camerondm9/ece4600capstone/README.md

# ece4600capstone
This repository is for storing files related to our Capstone project.
