camerondm9/ece4600capstone/Mechanical/Renders/Emittor 1.png

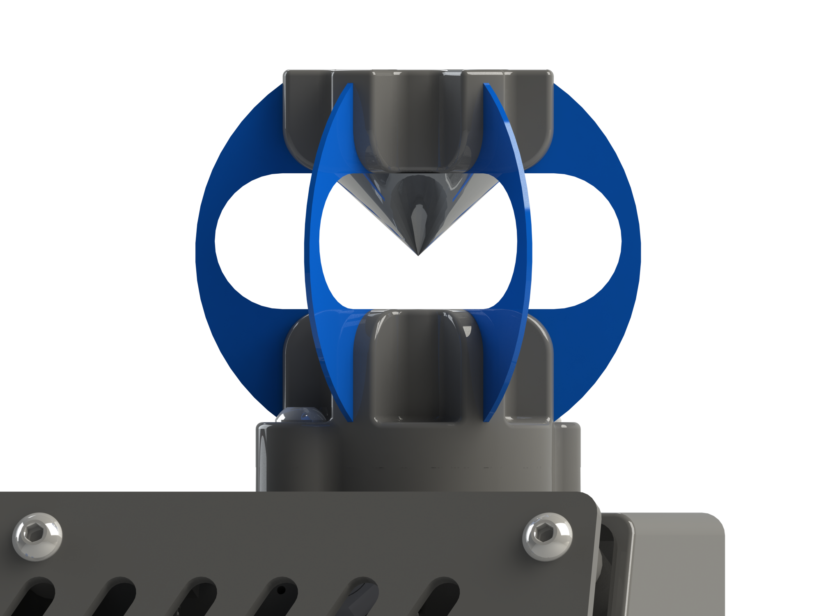
Mechanical/Renders/Emittor 1.png
