camerondm9/ece4600capstone/Mechanical/Renders/Isometric 2.png

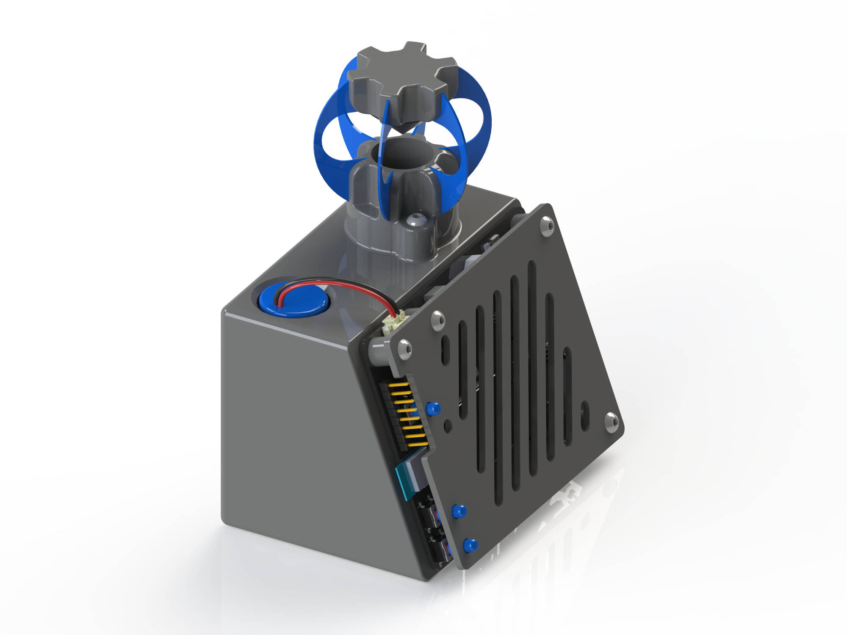
Mechanical/Renders/Isometric 2.png
