camerondm9/ece4600capstone/Mechanical/Renders/Isometric.png

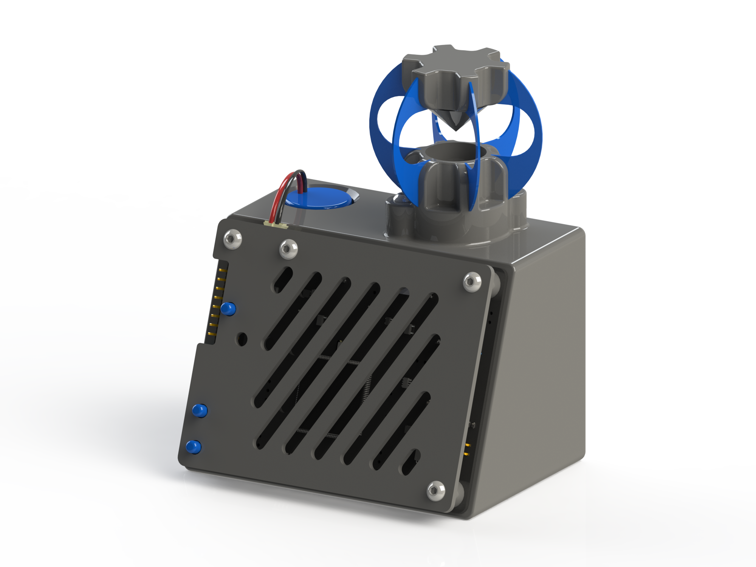
Mechanical/Renders/Isometric.png
