camerondm9/ece4600capstone/PCB/bom/layout.csv

Id | Designator | Package | Quantity | Designation | Supplier and ref
1 | D3,D2 | DO-220AA | 2 | 560mV 2.1A
2 | R28,R3 | R_0603_HandSoldering | 2 | 20k
3 | R27 | R_0603_HandSoldering | 1 | 100m
4 | R26,R21,R48,R46,R14 | R_0603_HandSoldering | 5 | 220k
5 | R25 | R_0603_HandSoldering | 1 | 100
6 | R24,R20,R19,R60,R59,R58,R57,R45,R39,R38,R37,R36,R35,R33,R32,R31,R30,R29,R17,R7 | R_0603_HandSoldering | 20 | 10k
7 | R23 | R_0603_HandSoldering | 1 | 392k
8 | R22,R64,R62,R9 | R_0603_HandSoldering | 4 | 30k
9 | R18 | R_0603_HandSoldering | 1 | 86.6k
10 | C89 | C_1206_HandSoldering | 1 | 2.2uF
11 | U18,U19 | TDFN8-PAD | 2 | MAX5394L
12 | Ref** | BottomLogo | 1 | Val**
13 | C99,C98,C97,C96 | C_0805_HandSoldering | 4 | 68nF
14 | C103,C101,C94,C84,C81,C71,C70,C29,C28,C22,C21,C19,C18,C14,C13,C12,C11,C10,C8,C3,C2,C1 | C_0805_HandSoldering | 22 | 10uF
15 | R61,R44,R34 | R_0603_HandSoldering | 3 | 1k
16 | L6 | SRU1048-151Y | 1 | 150uH
17 | U12 | EQFP144-PAD | 1 | 10CL010
18 | L5 | NRS6045T100MMGK | 1 | 10uH
19 | C15,C16,C4 | CP_Radial_D6.3mm_P2.50mm | 3 | 330uF
20 | NT2,NT4,NT3,NT1 | NetTie-2 | 4 | Net-Tie_2
21 | SW1,SW2,SW3 | PTS645SK43SM | 3 | SW_Push
22 | H4,H3,H2,H1 | MountingHole_4mm_Pad_Via | 4 | MountingHole_Pad
23 | J1 | JST_S2B-PH-SM4-TB | 1 | S2B-PH-SM4-TB
24 | U1 | WSON10-PAD | 1 | TPS63031
25 | J8 | Pin_Header_Straight_1x08_Pitch2.54mm | 1 | DNP
26 | J5 | Pin_Header_Straight_1x15_Pitch2.54mm | 1 | DNP
27 | U7 | SOIC8 | 1 | W25Q80DV
28 | J12 | Pin_Header_Straight_1x04_Pitch2.54mm | 1 | DNP
29 | U13 | ECS-5032MV | 1 | ECS-5032MV
30 | C49,C102,C100,C93,C92,C91,C85,C83,C79,C78,C68,C67,C66,C48,C47,C46,C45,C44,C37,C27,C26,C25,C24,C20,C5 | C_0603_HandSoldering | 25 | 100nF
31 | J10 | Pin_Header_Straight_2x05_Pitch2.54mm | 1 | DNP
32 | U21 | SSOP14 | 1 | TLV3544
33 | U22 | SOT23-5 | 1 | MCP6L1
34 | U20 | SOT23 | 1 | MAX11116
35 | U17 | SSOP8 | 1 | ADA4522-1
36 | U16 | TSOT8 | 1 | AD5450
37 | U15 | SOIC8-PAD | 1 | LTC6090-5
38 | U14 | SOT23-5 | 1 | TSX9291
39 | U11 | SSOP8 | 1 | LM3478
40 | U10 | SOT23-5 | 1 | AP2204K-ADJ
41 | U9 | WSON6-3x3-PAD | 1 | LMR62421
42 | U8 | LGA12 | 1 | LIS2DE12
43 | U6 | QFN4-PAD | 1 | ENS210
44 | U5 | SOT353 | 1 | MIC841N
45 | U4 | BMD-360 | 1 | BMD-360
46 | U3 | WSON6-2x2-PAD | 1 | TPS62262
47 | U2 | SOT23-5 | 1 | TCR2EF25
48 | R65 | R_1206_HandSoldering | 1 | 10k
49 | R63 | R_0603_HandSoldering | 1 | 1
50 | R56,R55 | R_0603_HandSoldering | 2 | 330
51 | R54,R53 | R_0603_HandSoldering | 2 | 2.7k
52 | R52,R51 | R_0603_HandSoldering | 2 | 7.5k
53 | R50,R49 | R_0603_HandSoldering | 2 | 47k
54 | R47 | R_0603_HandSoldering | 1 | 10
55 | R43,R42,R40 | R_0603_HandSoldering | 3 | 15k
56 | R41 | R_0603_HandSoldering | 1 | 75k
57 | R16 | R_0603_HandSoldering | 1 | 27k
58 | R15,R6,R4 | R_0603_HandSoldering | 3 | 3.3k
59 | R13,R12 | R_0603_HandSoldering | 2 | 470k
60 | R11,R5 | R_0603_HandSoldering | 2 | 30
61 | R10,R8 | R_0603_HandSoldering | 2 | 47
62 | R2,R1 | R_0805_HandSoldering | 2 | 100m
63 | Q1 | UDFN6-FET-PAD | 1 | SSM6K361NU
64 | L4,L2 | R_0805_HandSoldering | 2 | 100nH
65 | L3,L1 | Inductor_Taiyo-Yuden_MD-3030 | 2 | 2.2uH
66 | JP8,JP7,JP6,JP5,JP4,JP3,JP2,JP1 | SolderJumper_0603 | 8 | 0
67 | J11,J9,J7,J6,J3 | Pin_Header_Straight_1x02_Pitch2.54mm | 5 | DNP
68 | J4 | Pin_Header_Straight_1x08_Pitch2.54mm | 1 | PH1-08-UA
69 | J2 | Pin_Header_Straight_1x02_Pitch2.54mm | 1 | TRANSDUCER
70 | D8,D7,D5,D4 | D_SOD-523 | 4 | 600mV 200mA
71 | D6 | D_SOD-123 | 1 | 2.7V
72 | D1 | CLMVC-FKA | 1 | LED_ABGR
73 | C104,C90,C57,C56,C55,C54,C53,C52,C51,C50,C32 | C_0603_HandSoldering | 11 | 2.2nF
74 | C95,C87,C86 | C_1206_HandSoldering | 3 | 100nF
75 | C88,C82 | C_1206_HandSoldering | 2 | 220nF
76 | C80,C69,C17,C9,C7,C6 | C_0603_HandSoldering | 6 | 1uF
77 | C77,C76,C75,C74,C73,C72,C65,C64,C63,C62,C61,C60,C59,C58 | C_0603_HandSoldering | 14 | 22nF
78 | C43 | C_0603_HandSoldering | 1 | 10pF
79 | C42,C41,C40 | C_0603_HandSoldering | 3 | 220pF
80 | C39,C38 | CP_Radial_D10.0mm_P5.00mm | 2 | 220uF
81 | C36,C35,C31,C30 | C_1206_HandSoldering | 4 | 10uF
82 | C34,C33 | C_0805_HandSoldering | 2 | 1uF
83 | C23 | C_0603_HandSoldering | 1 | 10nF
