camerondm9/ece4600capstone/Datasheets/Parts.txt

Radio module:
	uBlox BMD-360
	https://www.digikey.ca/product-detail/en/u-blox-america-inc/BMD-360-A-R/1604-BMD-360-A-RCT-ND/10279460
	(has microcontroller)

Microcontroller:
	Nordic nRF52811
	(on radio module)

Transducer:
	Unictron A300A
	https://www.digikey.ca/product-detail/en/unictron-technologies-corporation/H2KA300KA1CD00/2047-H2KA300KA1CD00-ND/9921568

OpAmps:
	Maxim MAX412
	https://www.digikey.ca/product-detail/en/maxim-integrated/MAX412BCPA/MAX412BCPA-ND/1701712

	TI OPA604
	https://www.digikey.ca/product-detail/en/texas-instruments/OPA604AP/OPA604AP-ND/251162

FPGA:
	Intel/Altera 10CL010YE144C8G
	https://www.digikey.ca/product-detail/en/intel/10CL010YE144C8G/544-3578-ND/7593560
	https://www.intel.com/content/www/us/en/programmable/products/fpga/cyclone-series/cyclone-10/cyclone-10-lp/support.html
