camerondm9/ece4600capstone/Mechanical/Emittor Cover.SLDPRT

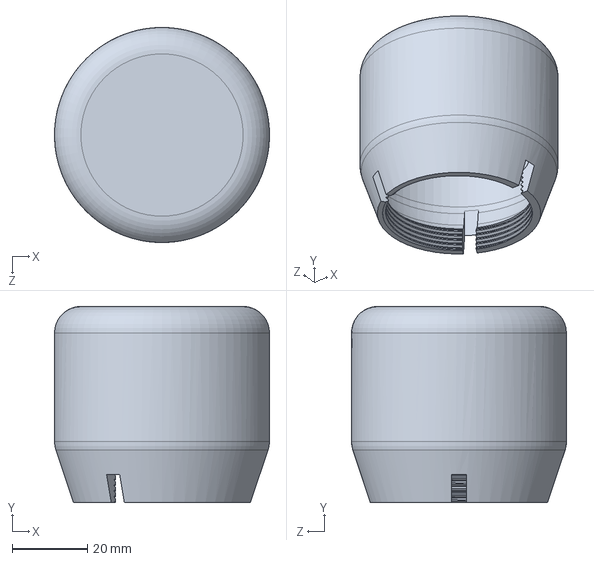
[picture p4: CAD file, 2020-02-05]
Mechanical/Emittor Cover.SLDPRT
57.0 x 52.0 x 57.0 mm
