camerondm9/ece4600capstone/PCB/Parts.3d/DO-220AA.step

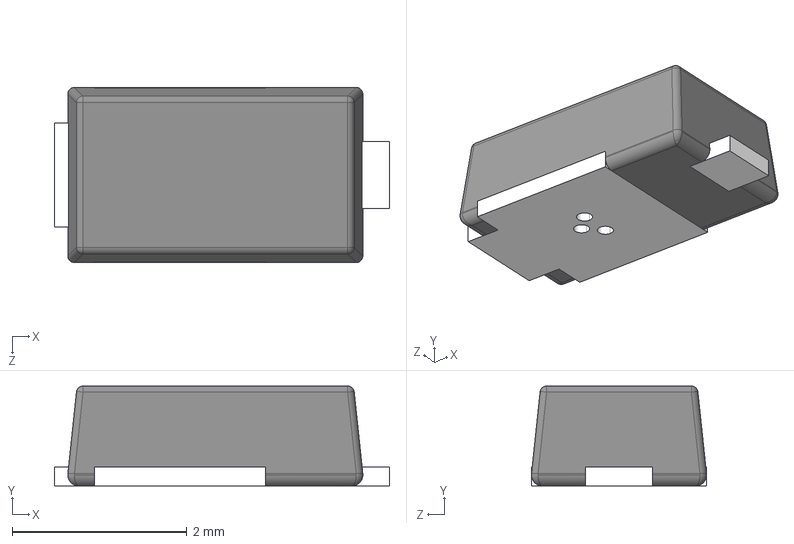
[picture p5: CAD file, 2020-01-10]
PCB/Parts.3d/DO-220AA.step
3.83 x 1.14 x 2.00 mm
