camerondm9/ece4600capstone/Mechanical/Cone Support.SLDPRT

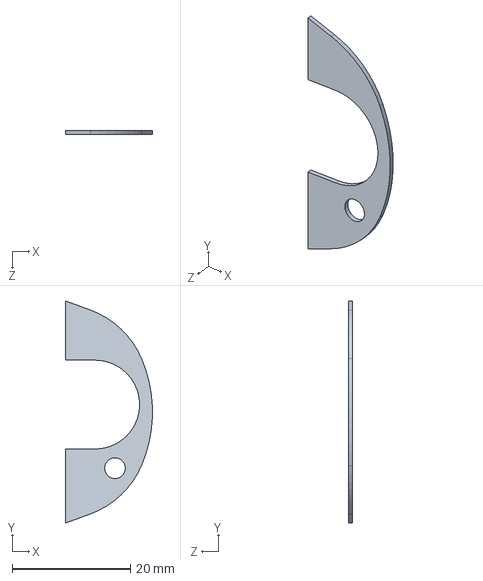
[picture p6: CAD file, 2020-02-05]
Mechanical/Cone Support.SLDPRT
14.7 x 37.5 x 0.7 mm
