camerondm9/ece4600capstone/PCB/Parts.3d/LQH3NP_M0.stp

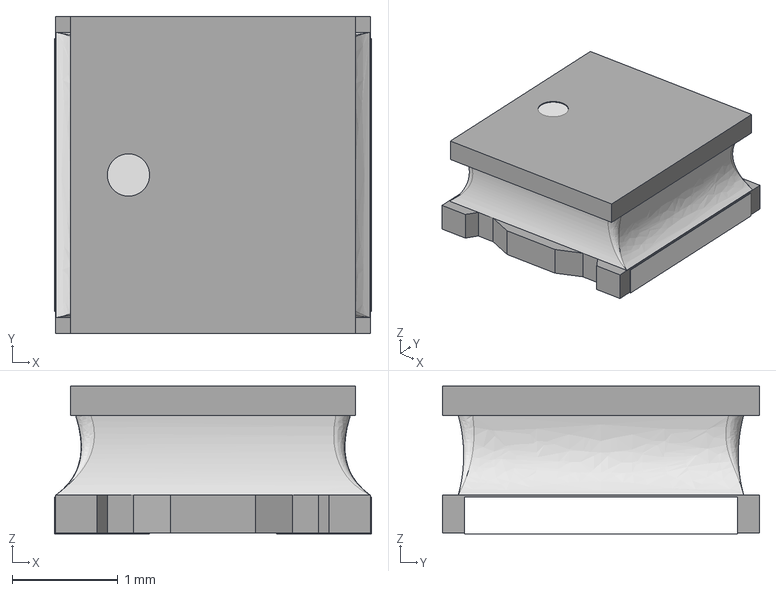
[picture p7: CAD file, 2019-12-18]
PCB/Parts.3d/LQH3NP_M0.stp
3.00 x 3.00 x 1.40 mm
