camerondm9/ece4600capstone/Mechanical/Emittor Mounting 3 Wing.SLDPRT

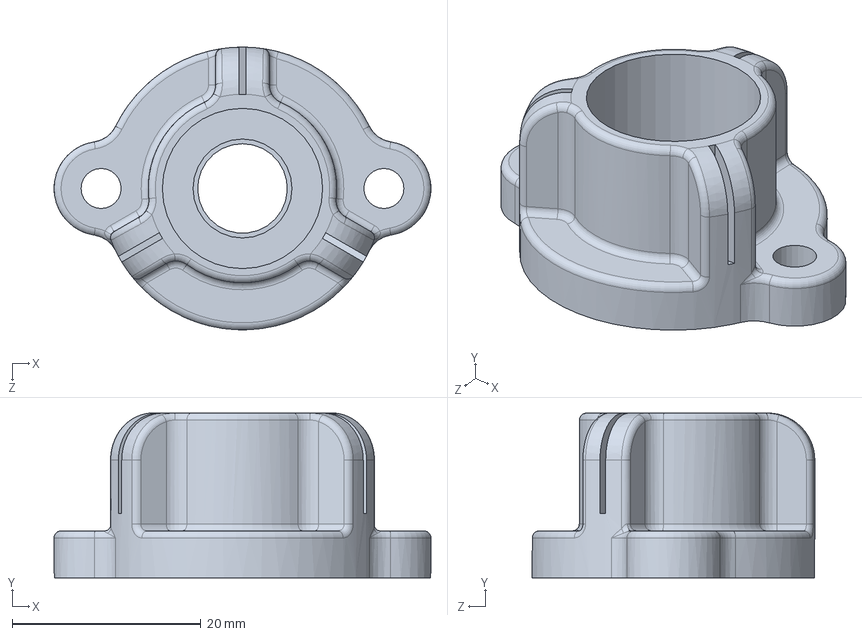
[picture p8: CAD file, 2020-02-05]
Mechanical/Emittor Mounting 3 Wing.SLDPRT
40.0 x 17.5 x 30.0 mm
