camerondm9/ece4600capstone/PCB/Parts.3d/SRU1048-151Y.stp

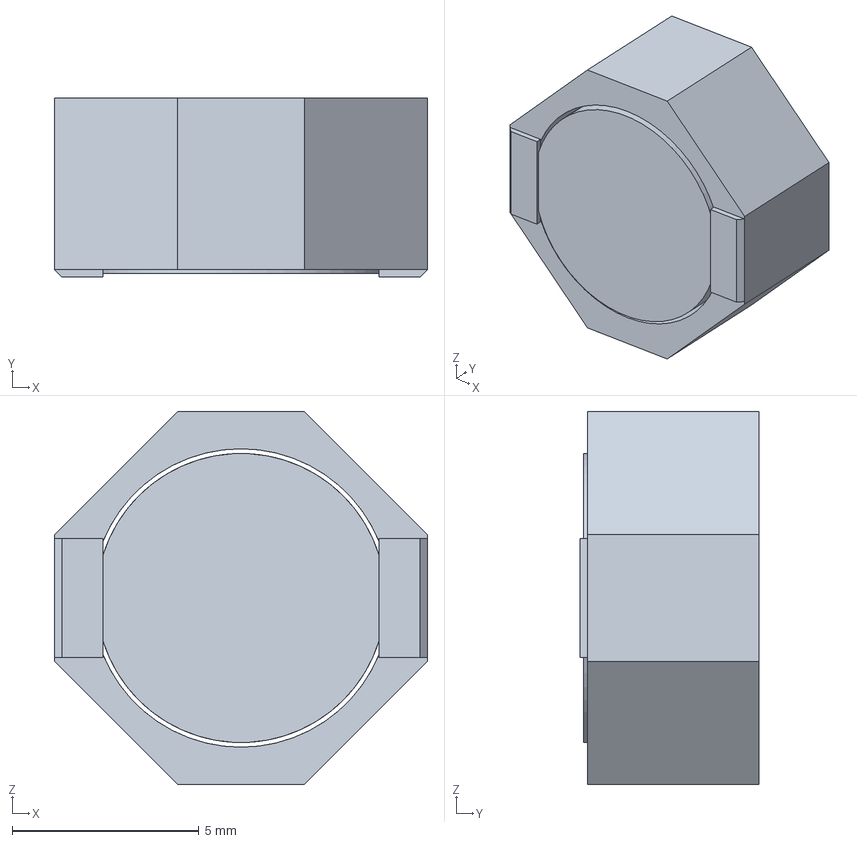
[picture p9: CAD file, 2019-12-18]
PCB/Parts.3d/SRU1048-151Y.stp
10.0 x 4.80 x 10.0 mm
