camerondm9/ece4600capstone/Mechanical/Base.SLDPRT

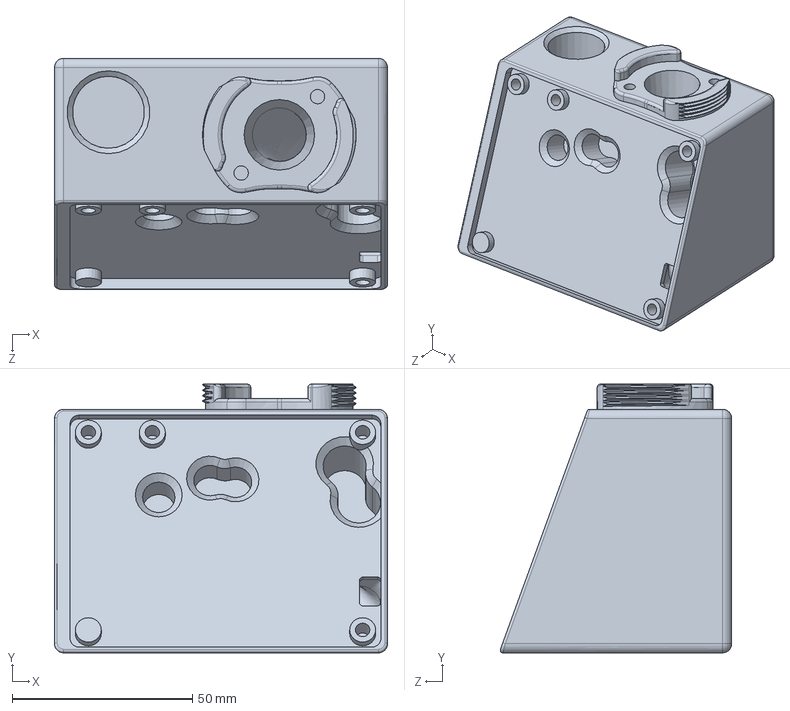
[picture p10: CAD file, 2020-02-05]
Mechanical/Base.SLDPRT
92.5 x 74.7 x 64.3 mm
