camerondm9/ece4600capstone/PCB/Parts.3d/TDFN8.step

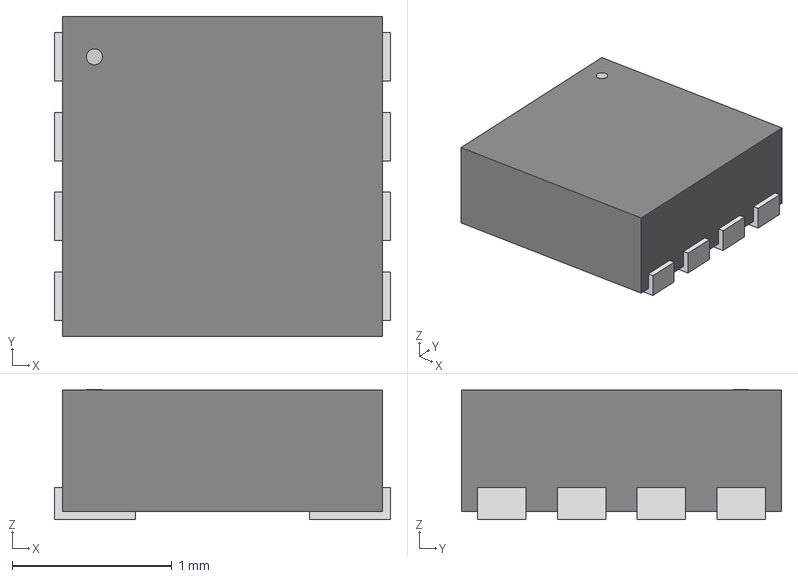
[picture p11: CAD file, 2019-12-13]
PCB/Parts.3d/TDFN8.step
2.11 x 2.01 x 0.815 mm
