camerondm9/ece4600capstone/PCB/Parts.3d/SSOP14.step

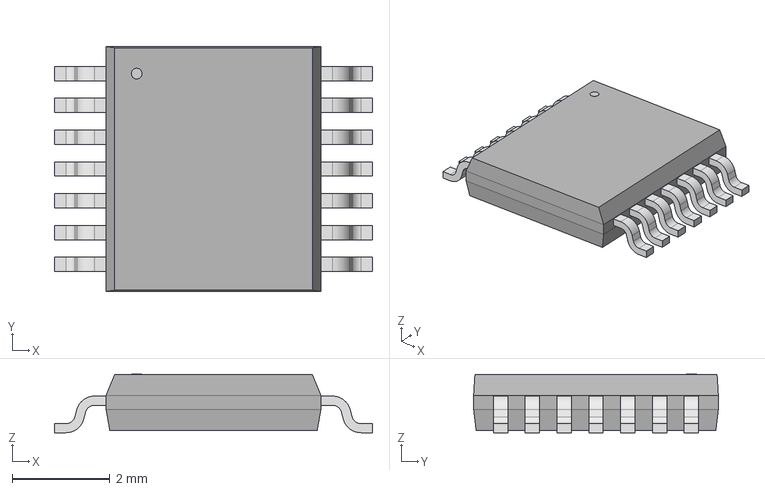
[picture p12: CAD file, 2019-12-13]
PCB/Parts.3d/SSOP14.step
6.50 x 5.00 x 1.20 mm
