camerondm9/ece4600capstone/Mechanical/Button Extender.SLDPRT

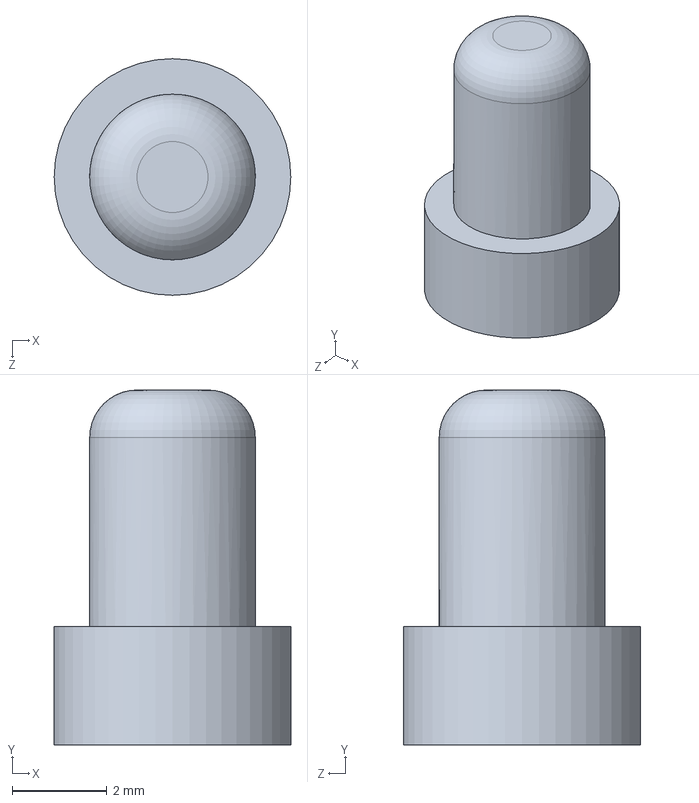
[picture p13: CAD file, 2020-02-05]
Mechanical/Button Extender.SLDPRT
5.00 x 7.50 x 5.00 mm
