camerondm9/ece4600capstone/PCB/Parts.3d/SOT353.step

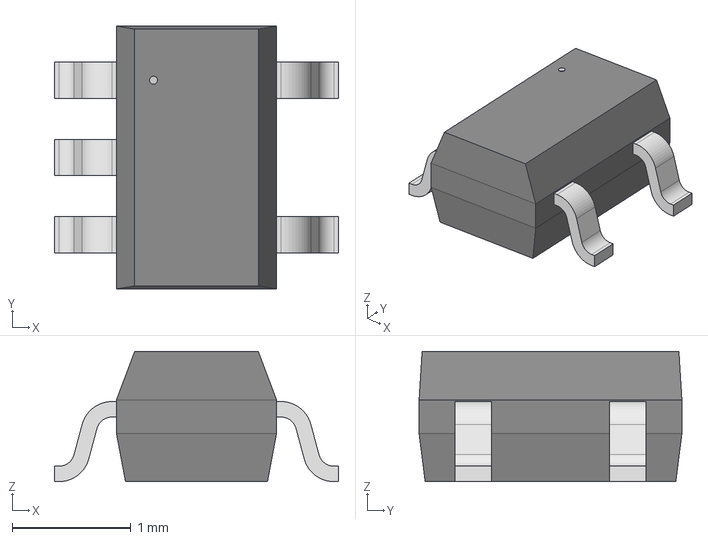
[picture p14: CAD file, 2019-12-05]
PCB/Parts.3d/SOT353.step
2.39 x 2.21 x 1.09 mm
