camerondm9/ece4600capstone/PCB/Parts.3d/SSOP8.step

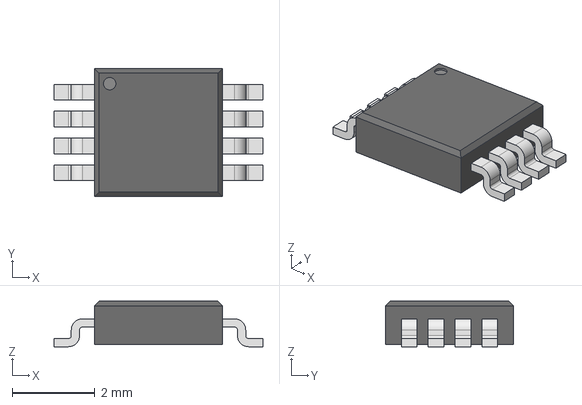
[picture p15: CAD file, 2019-12-02]
PCB/Parts.3d/SSOP8.step
5.05 x 3.10 x 1.10 mm
