camerondm9/ece4600capstone/Mechanical/Cone Mount 3 Wing.SLDPRT

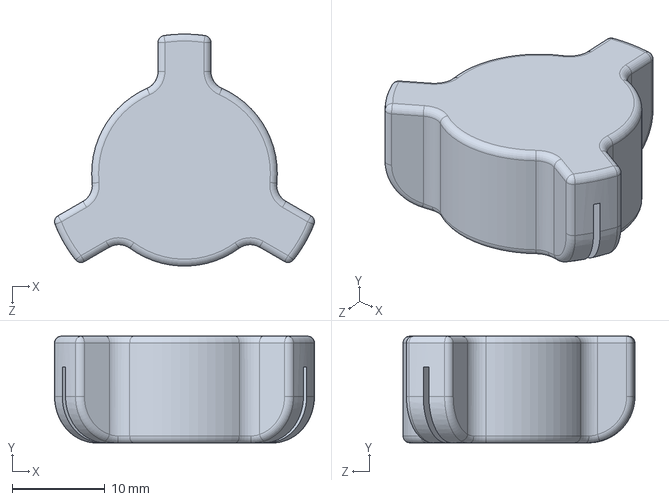
[picture p16: CAD file, 2020-02-05]
Mechanical/Cone Mount 3 Wing.SLDPRT
28.0 x 11.5 x 25.0 mm
