camerondm9/ece4600capstone/Mechanical/Cone.SLDPRT

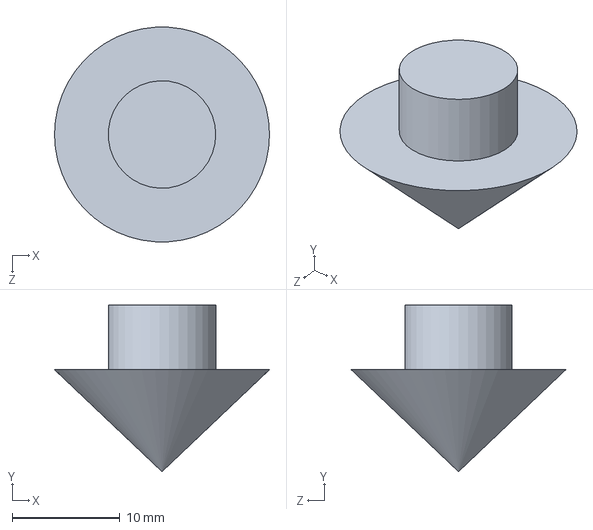
[picture p17: CAD file, 2020-01-29]
Mechanical/Cone.SLDPRT
20.0 x 15.5 x 20.0 mm
