camerondm9/ece4600capstone/PCB/Parts.3d/WSON6-3x3-PAD.step

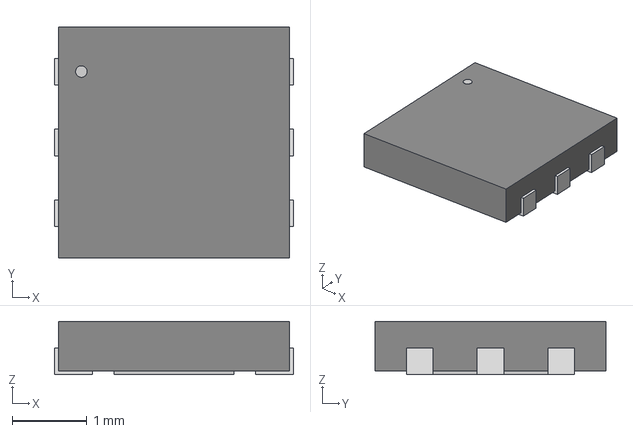
[picture p18: CAD file, 2019-11-28]
PCB/Parts.3d/WSON6-3x3-PAD.step
3.20 x 3.10 x 0.714 mm
