camerondm9/ece4600capstone/Mechanical/Cover.SLDPRT

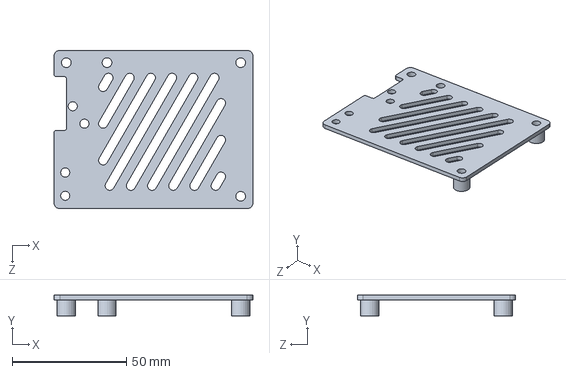
[picture p19: CAD file, 2020-01-28]
Mechanical/Cover.SLDPRT
87.0 x 9.00 x 69.2 mm
