camerondm9/ece4600capstone/PCB/Parts.3d/NRS6045T100MMGK.step

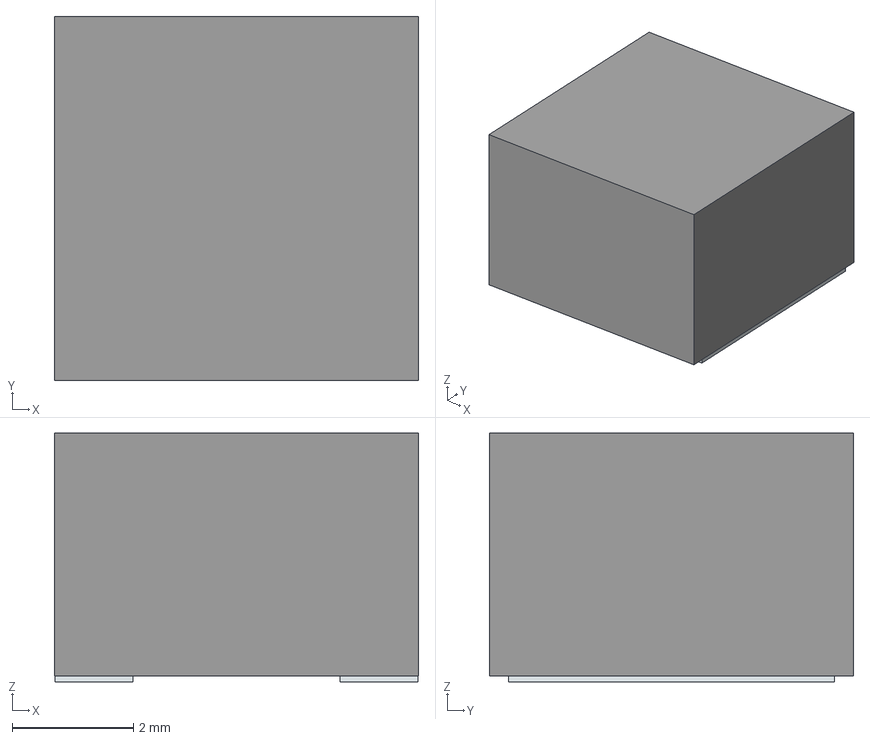
[picture p20: CAD file, 2019-11-28]
PCB/Parts.3d/NRS6045T100MMGK.step
6.00 x 6.00 x 4.10 mm
('pin',_'1')
('pin',_'2')
