camerondm9/ece4600capstone/Mechanical/Cone Mount.SLDPRT

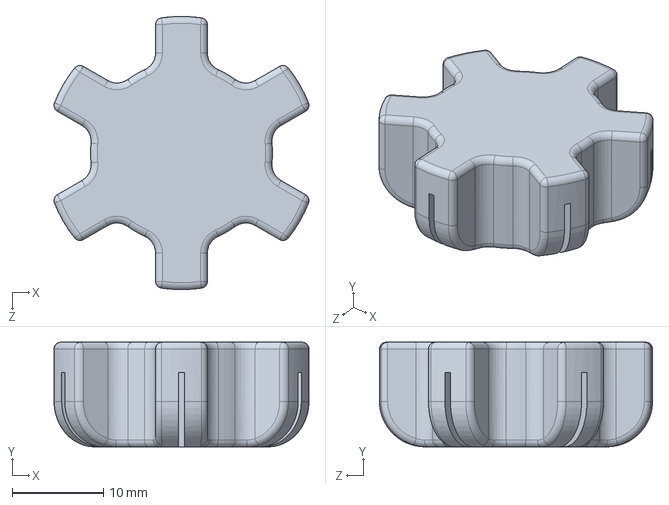
[picture p21: CAD file, 2020-01-16]
Mechanical/Cone Mount.SLDPRT
28.0 x 11.5 x 30.0 mm
