camerondm9/ece4600capstone/PCB/Parts.3d/WSON6-2x2-PAD.step

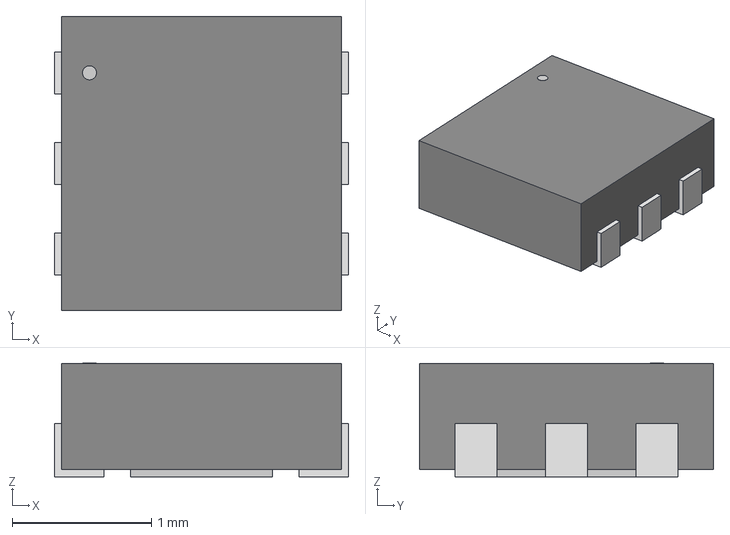
[picture p22: CAD file, 2019-11-18]
PCB/Parts.3d/WSON6-2x2-PAD.step
2.11 x 2.11 x 0.815 mm
