camerondm9/ece4600capstone/Mechanical/Battery.SLDPRT

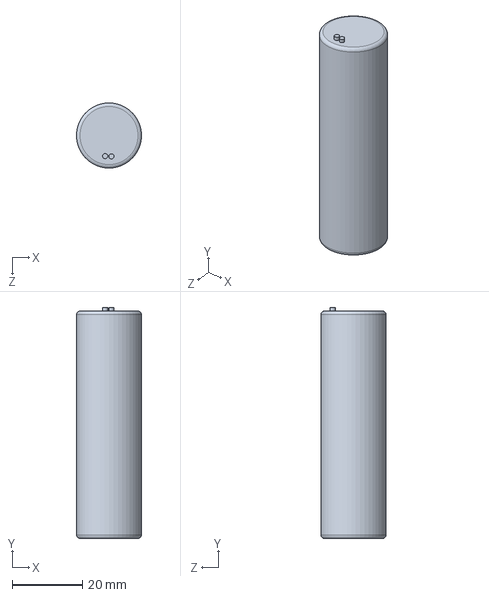
[picture p23: CAD file, 2020-01-16]
Mechanical/Battery.SLDPRT
18.6 x 66.0 x 18.6 mm
