camerondm9/ece4600capstone/PCB/Parts.3d/SOIC8-PAD.step

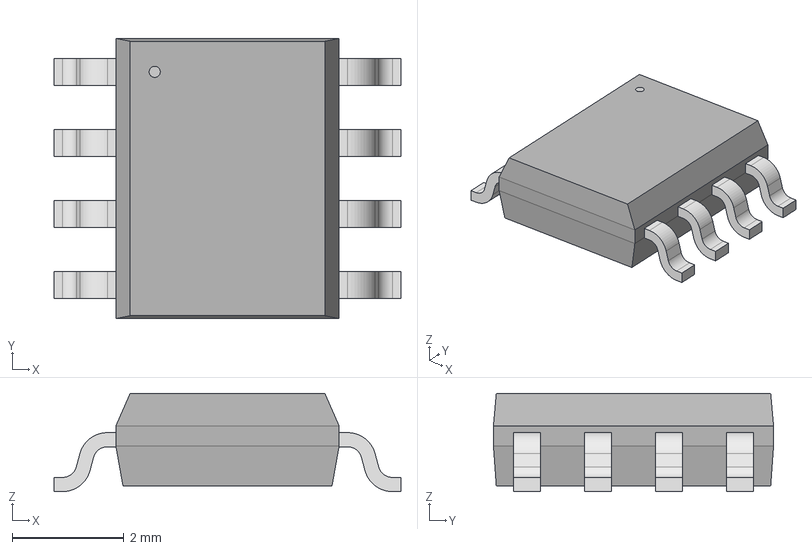
[picture p24: CAD file, 2019-11-17]
PCB/Parts.3d/SOIC8-PAD.step
6.20 x 5.00 x 1.75 mm
