camerondm9/ece4600capstone/Mechanical/JST Connector.sldprt

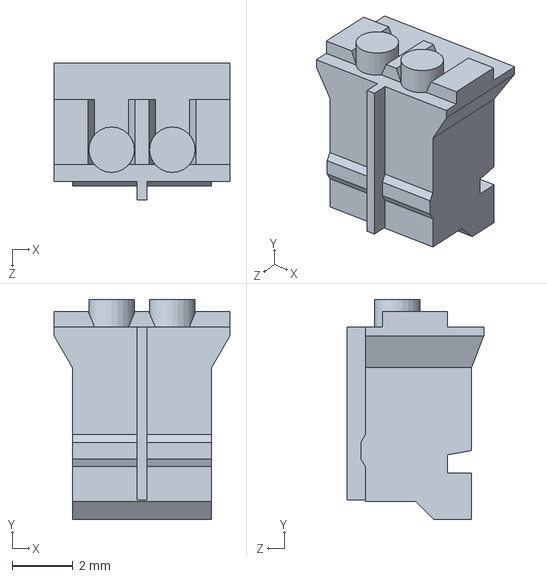
[picture p25: CAD file, 2020-01-16]
Mechanical/JST Connector.sldprt
5.80 x 7.25 x 4.50 mm
