camerondm9/ece4600capstone/PCB/Parts.3d/S2B-PH-SM4-TB.step

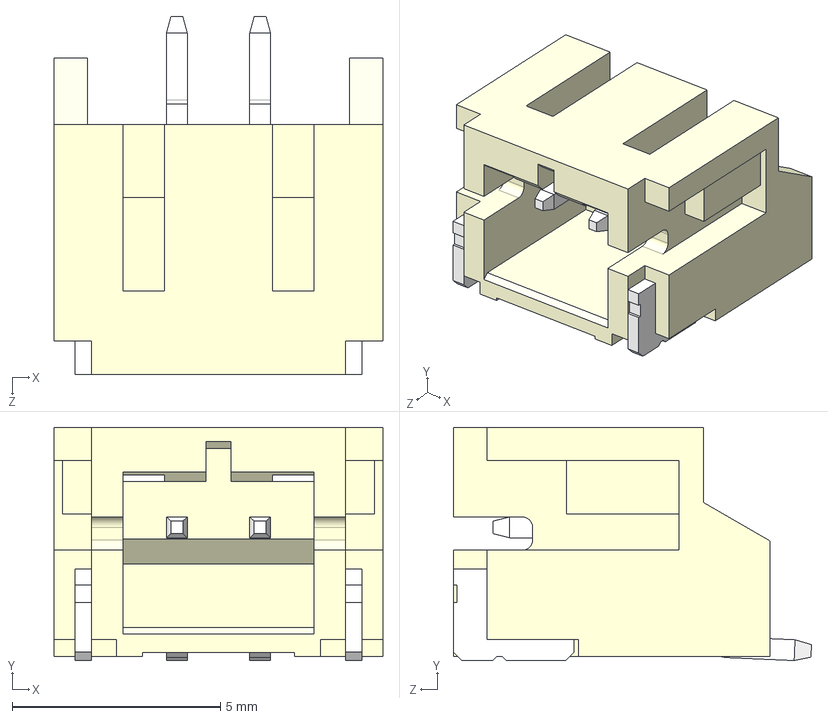
[picture p26: CAD file, 2019-11-15]
PCB/Parts.3d/S2B-PH-SM4-TB.step
7.90 x 5.60 x 8.60 mm
