camerondm9/ece4600capstone/Mechanical/Wires.SLDPRT

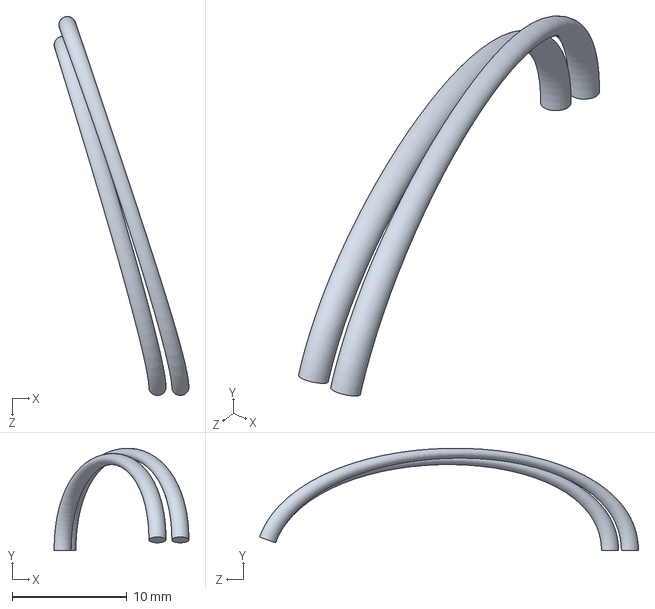
[picture p27: CAD file, 2020-01-16]
Mechanical/Wires.SLDPRT
11.8 x 8.94 x 33.1 mm
