camerondm9/ece4600capstone/PCB/Parts.3d/SOT23-5.step

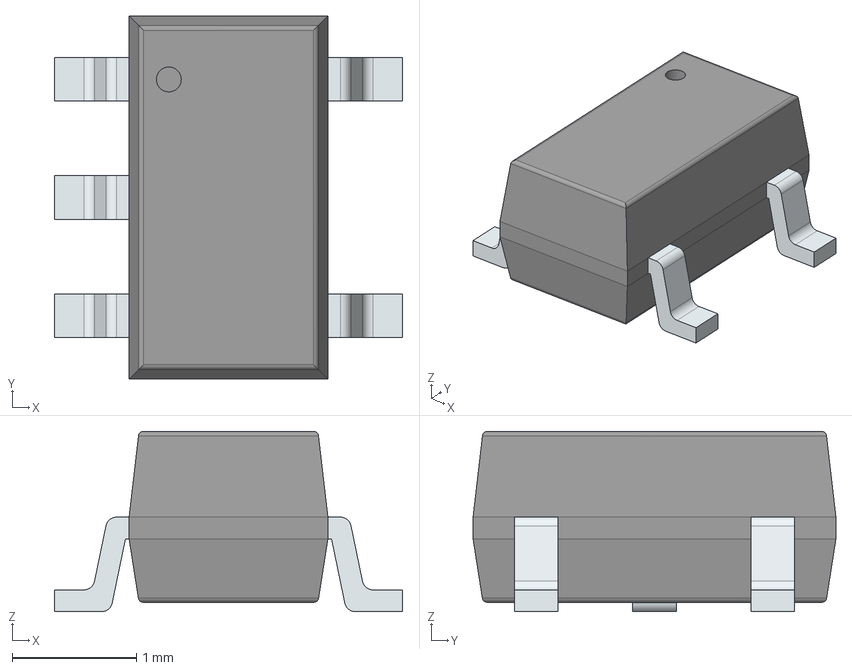
[picture p28: CAD file, 2019-11-15]
PCB/Parts.3d/SOT23-5.step
2.80 x 2.92 x 1.45 mm
PinsArrayL
PinsArrayR
