camerondm9/ece4600capstone/Mechanical/2 Pin Header.SLDPRT

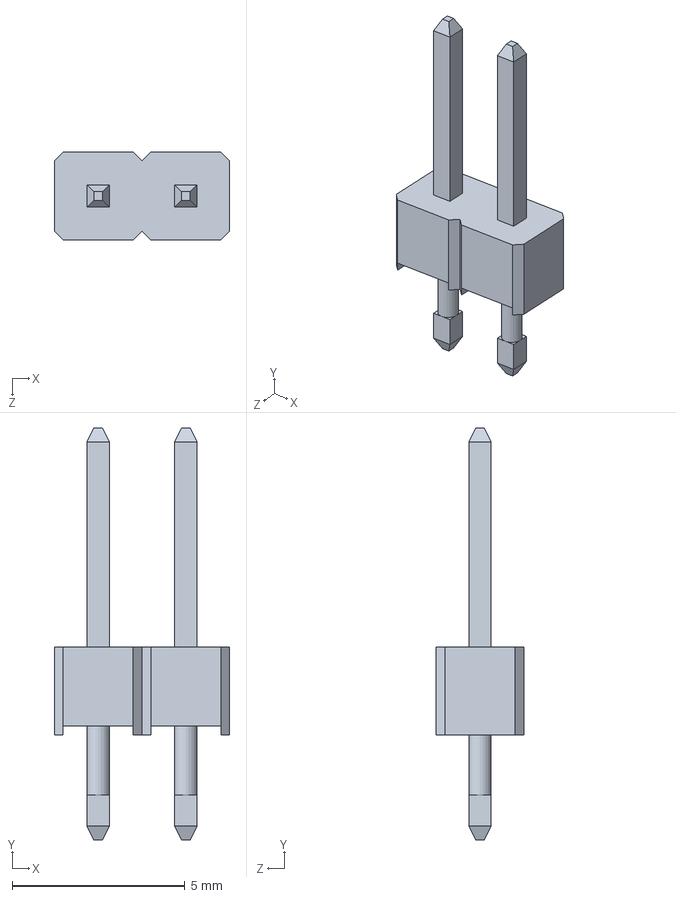
[picture p29: CAD file, 2020-01-16]
Mechanical/2 Pin Header.SLDPRT
5.08 x 11.9 x 2.54 mm
