camerondm9/ece4600capstone/PCB/Parts.3d/PTS645SK43SM.step

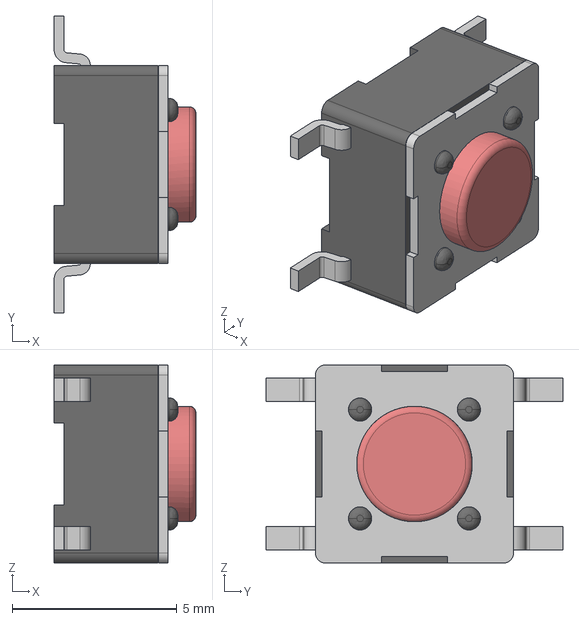
[picture p30: CAD file, 2019-11-15]
PCB/Parts.3d/PTS645SK43SM.step
4.30 x 9.00 x 6.00 mm
