camerondm9/ece4600capstone/Mechanical/Small Capacitor.SLDPRT

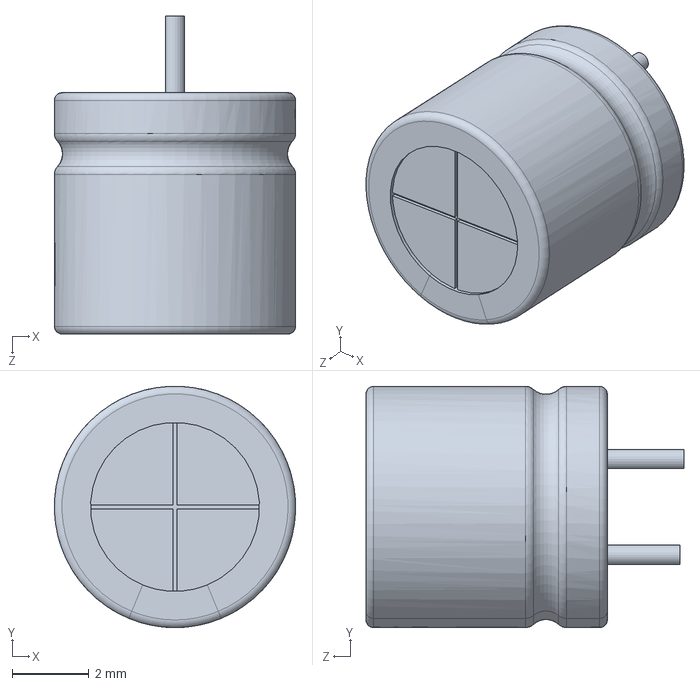
[picture p31: CAD file, 2020-01-16]
Mechanical/Small Capacitor.SLDPRT
6.30 x 6.30 x 8.30 mm
