camerondm9/ece4600capstone/PCB/Parts.3d/BMD-360.step

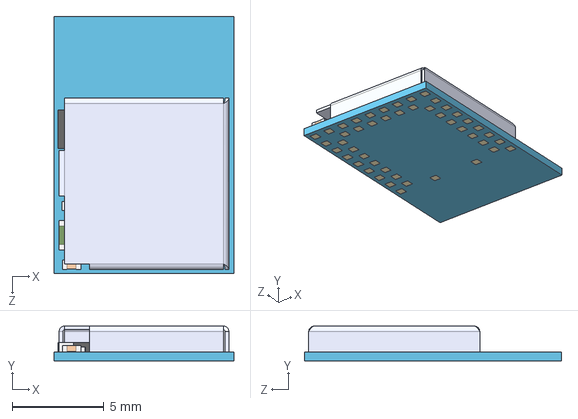
[picture p32: CAD file, 2019-11-15]
PCB/Parts.3d/BMD-360.step
9.80 x 1.90 x 14.0 mm
BMD-300-A-R board
BMD-300 cip
