camerondm9/ece4600capstone/PCB/Parts.3d/TSOT8.step

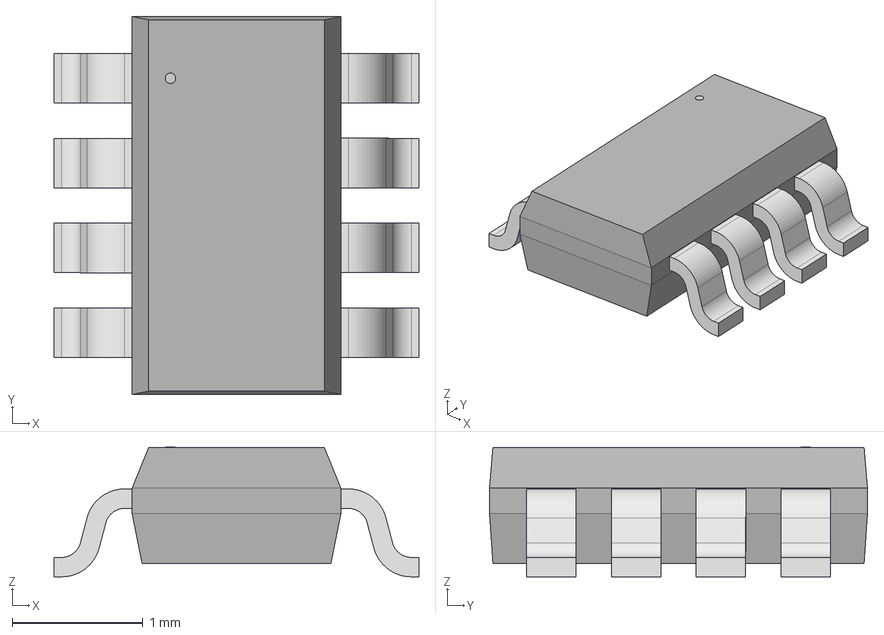
[picture p33: CAD file, 2019-11-14]
PCB/Parts.3d/TSOT8.step
2.79 x 2.90 x 0.993 mm
