camerondm9/ece4600capstone/Mechanical/Emittor.SLDPRT

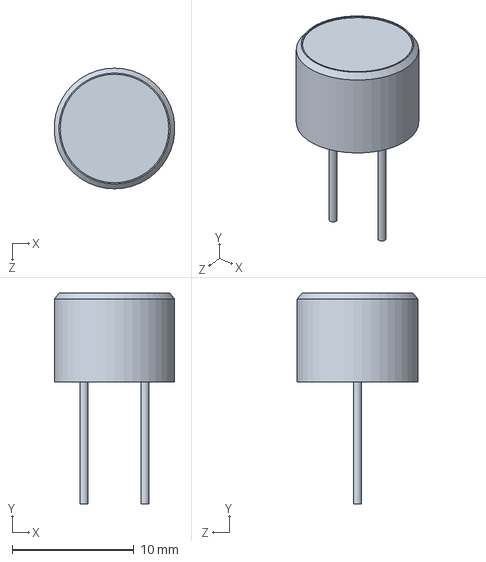
[picture p34: CAD file, 2020-01-16]
Mechanical/Emittor.SLDPRT
9.87 x 17.3 x 9.90 mm
