camerondm9/ece4600capstone/PCB/Parts.3d/SOT23.step

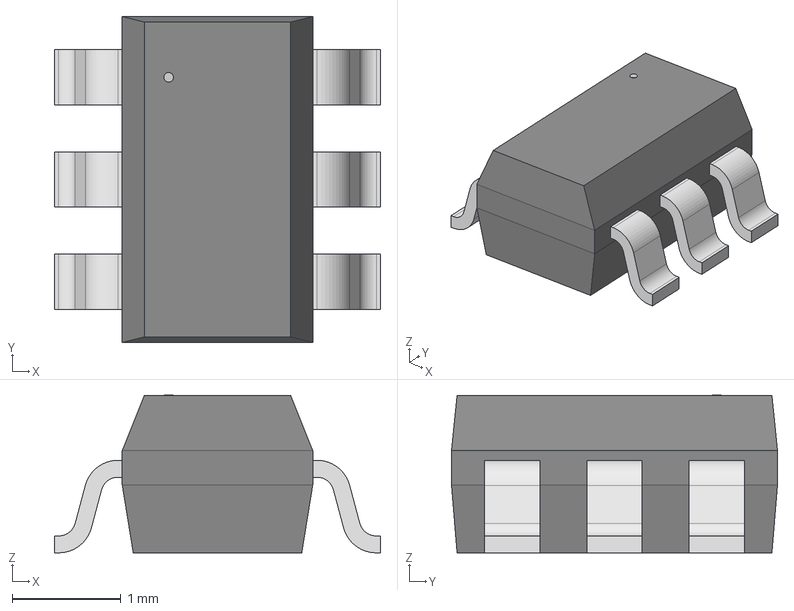
[picture p35: CAD file, 2019-11-14]
PCB/Parts.3d/SOT23.step
3.00 x 3.00 x 1.45 mm
