camerondm9/ece4600capstone/Mechanical/Large Capacitor (Extended).SLDPRT

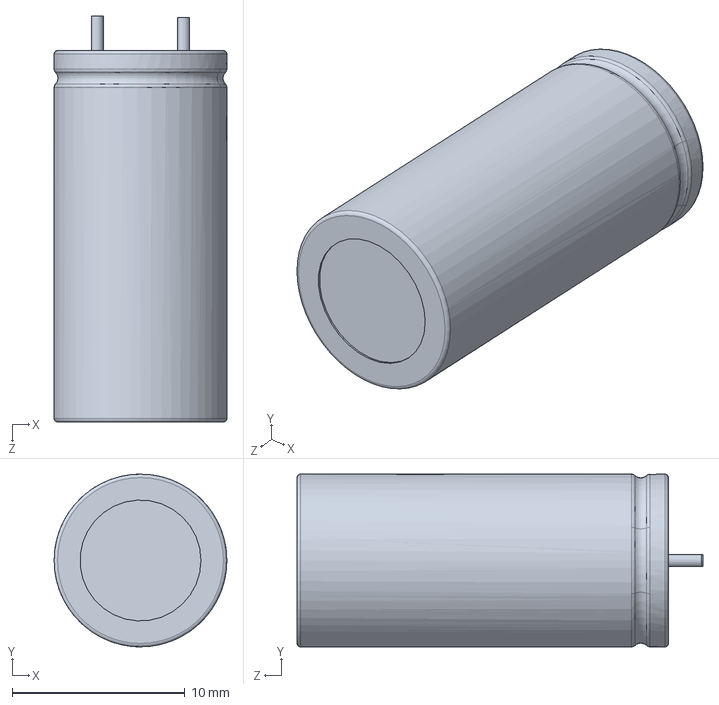
[picture p36: CAD file, 2020-01-16]
Mechanical/Large Capacitor (Extended).SLDPRT
10.00 x 10.00 x 23.5 mm
