camerondm9/ece4600capstone/PCB/Parts.3d/ECS-5032MV.step

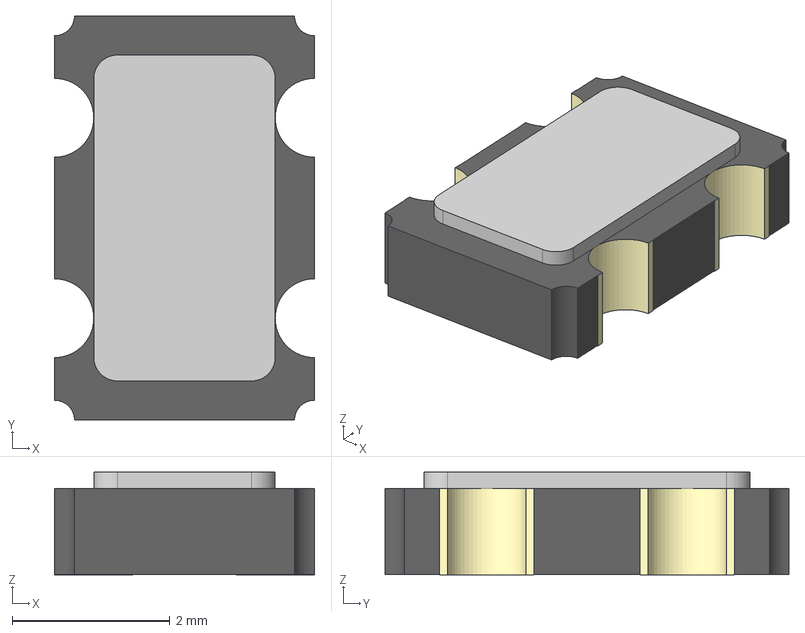
[picture p37: CAD file, 2019-11-14]
PCB/Parts.3d/ECS-5032MV.step
3.30 x 5.12 x 1.30 mm
