camerondm9/ece4600capstone/PCB/Parts.3d/WSON10-PAD.step

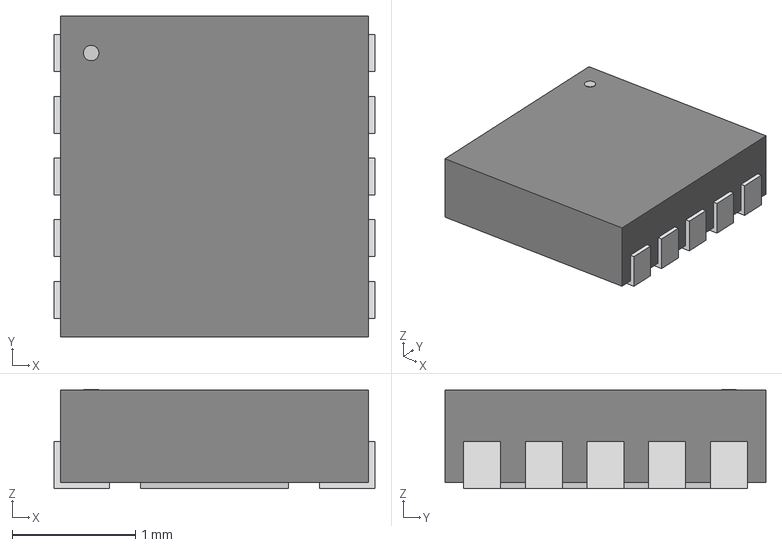
[picture p38: CAD file, 2019-11-14]
PCB/Parts.3d/WSON10-PAD.step
2.60 x 2.60 x 0.803 mm
