camerondm9/ece4600capstone/PCB/Parts.3d/CLMVC-FKA.step

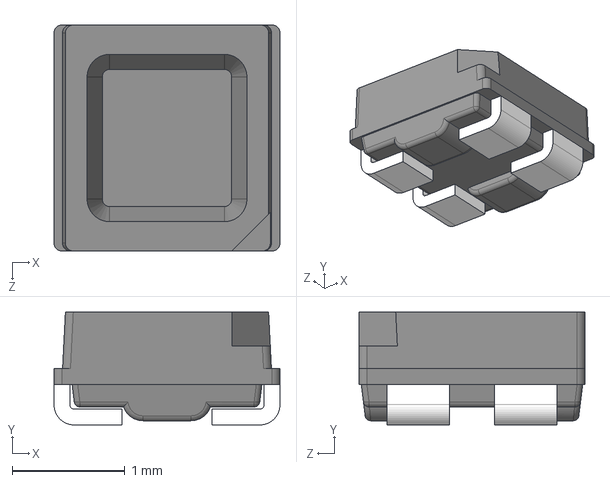
[picture p39: CAD file, 2019-11-14]
PCB/Parts.3d/CLMVC-FKA.step
2.00 x 1 x 2.00 mm
