camerondm9/ece4600capstone/PCB/Parts.3d/LGA12.step

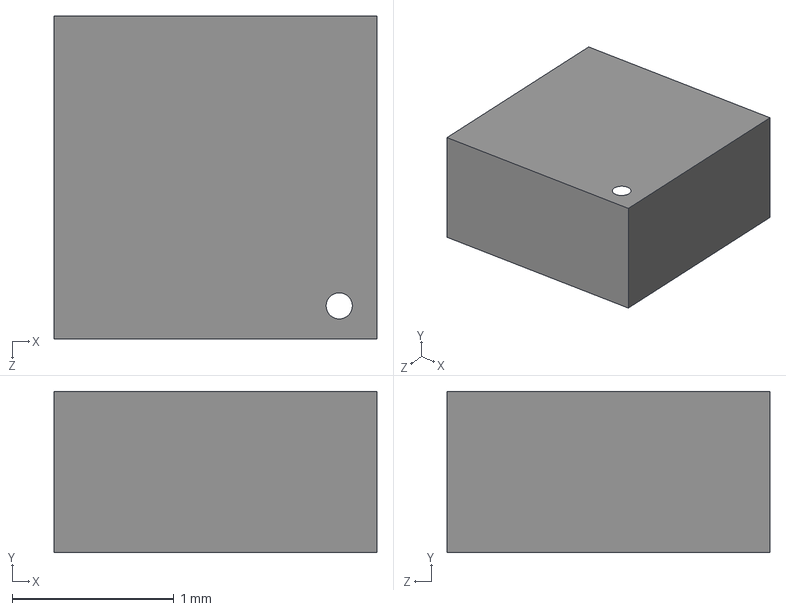
[picture p40: CAD file, 2019-11-14]
PCB/Parts.3d/LGA12.step
2.00 x 1.00 x 2.00 mm
