camerondm9/ece4600capstone/PCB/Parts.3d/QFN4-PAD.step

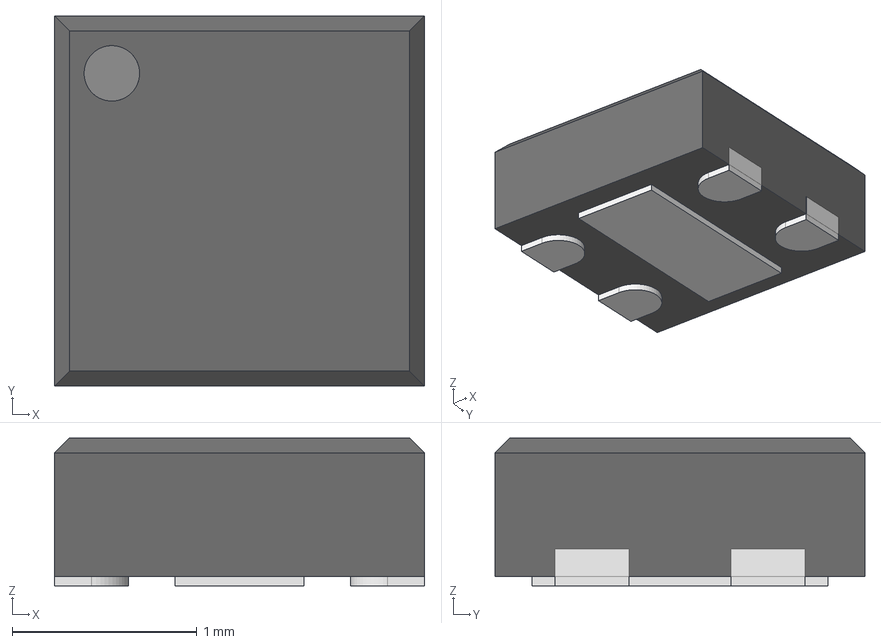
[picture p41: CAD file, 2019-11-14]
PCB/Parts.3d/QFN4-PAD.step
2.00 x 2.00 x 0.8 mm
