camerondm9/ece4600capstone/PCB/Parts.3d/EQFP144-PAD.step

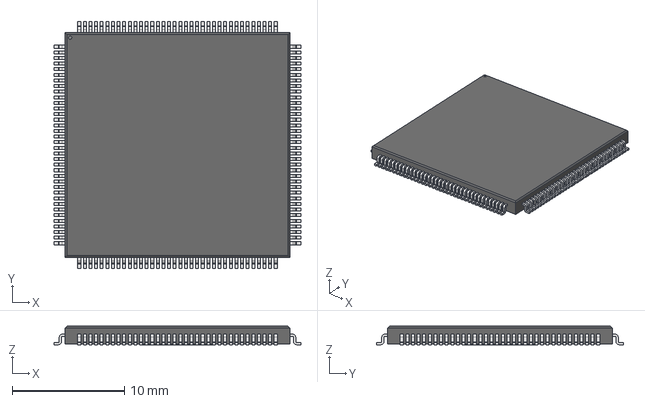
[picture p42: CAD file, 2019-11-14]
PCB/Parts.3d/EQFP144-PAD.step
22.0 x 22.0 x 1.65 mm
