camerondm9/ece4600capstone/(list of files, cad)

Other CAD files:
Mechanical/Emittor Mounting.SLDPRT
Mechanical/Header.stp
Mechanical/Drawings/ConeRev0.SLDDRW
Mechanical/Machine Screw (91772A150).SLDPRT
