camerondm9/ece4600capstone/Mechanical/Drawings/ConeRev1.PDF

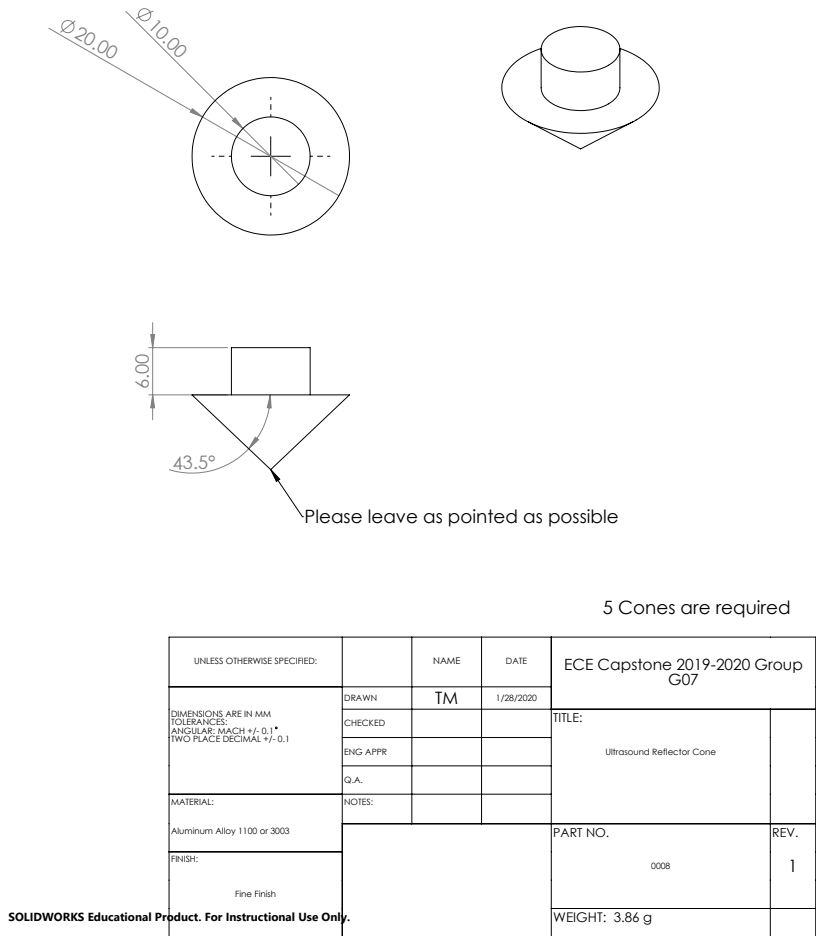
[picture p43: page 1]
Fine Finish; SOLIDWORKS Educational Product. For Instructional Use Only.; WEIGHT: 3.86 g

Please leave as pointed as possible

5 Cones are required

UNLESS OTHERWISE SPECIFIED: | | NAME | DATE | ECE Capstone 2019-2020 Group G07

DIMENSIONS ARE IN MM TOLERANCES: ANGULAR: MACH +/- 0.1 TWO PLACE DECIMAL +/- 0.1 | DRAWN | TM | 1/28/2020

CHECKED | | | TITLE: Ultrasound Reflector Cone

ENG APPR

MATERIAL: Aluminum Alloy 1100 or 3003 | NOTES:

PART NO. 0008 | REV. 1
