camerondm9/ece4600capstone/PCB/Capstone.kicad_pcb

## KiCad design PCB/Capstone.kicad_pcb (2021-01-14)

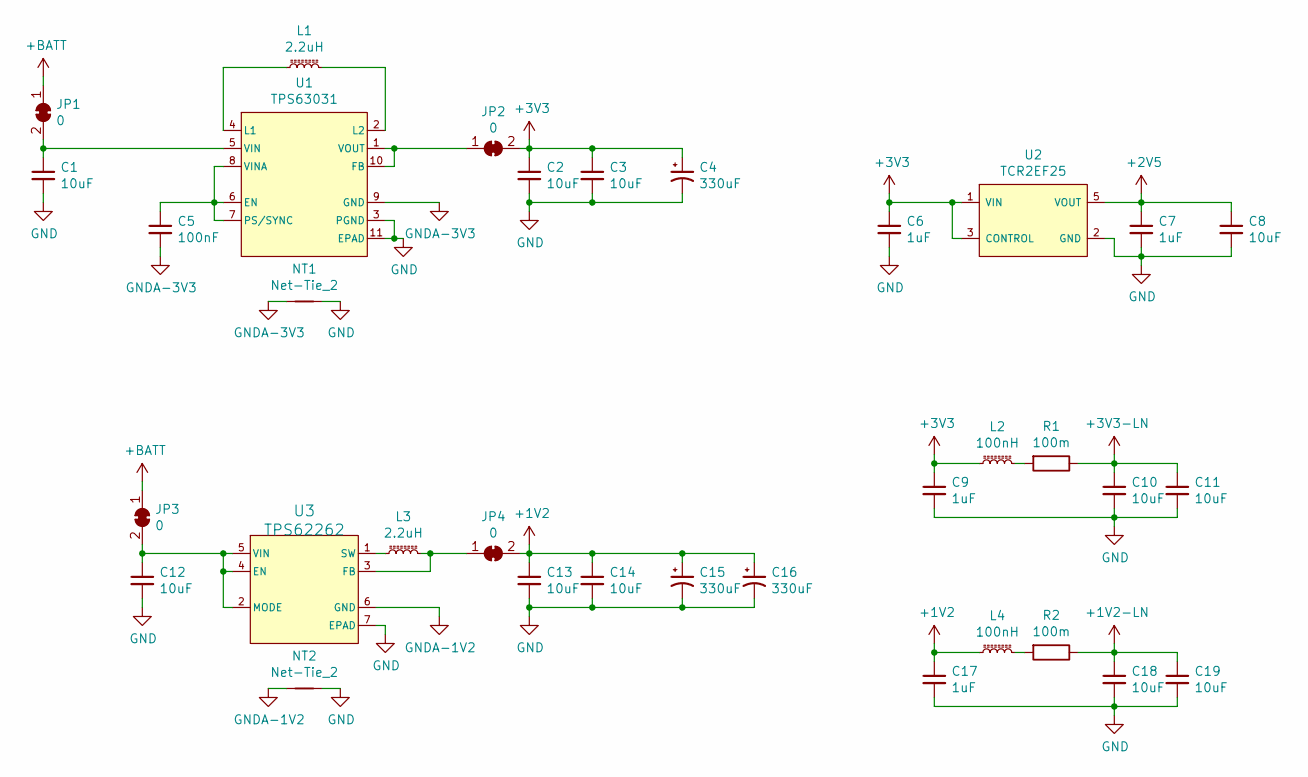
[picture p44: schematic LvPower.sch]

Parts:
C1, C2, C3, C8, C10, C11, C12, C13, C14, C18, C19: 10uF; C_0805_HandSoldering
C4, C15, C16: 330uF; CP_Radial_D6.3mm_P2.50mm
C5: 100nF; C_0603_HandSoldering
C6, C7, C9, C17: 1uF; C_0603_HandSoldering
JP1, JP2, JP3, JP4: 0; SolderJumper_0603
L1, L3: 2.2uH; Inductor_Taiyo-Yuden_MD-3030
L2, L4: 100nH; R_0805_HandSoldering
NT1, NT2: Net-Tie_2; NetTie-2
R1, R2: 100m; R_0805_HandSoldering
U1: TPS63031; WSON10-PAD
U2: TCR2EF25; SOT23-5
U3: TPS62262; WSON6-2x2-PAD

Connections:
+1V2: C13.1, C14.1, C15.1, C16.1, C17.1, JP4.2 (B), L4.1; also elsewhere on the board
+1V2-LN: C18.1, C19.1, R2.1; also elsewhere on the board
+2V5: C7.1, C8.1, U2.5 (VOUT); also elsewhere on the board
+3V3: C2.1, C3.1, C4.1, C6.1, C9.1, JP2.2 (B), L2.1, U2.1 (VIN), U2.3 (CONTROL); also elsewhere on the board
+3V3-LN: C10.1, C11.1, R1.1; also elsewhere on the board
+BATT: JP1.1 (A), JP3.1 (A); also elsewhere on the board
GND: C1.2, C2.2, C3.2, C4.2, C6.2, C7.2, C8.2, C9.2, C10.2, C11.2, C12.2, C13.2, C14.2, C15.2, C16.2, C17.2, C18.2, C19.2, NT1.2, NT2.2, U1.3 (PGND), U1.11 (EPAD), U2.2 (GND), U3.7 (EPAD); also elsewhere on the board
GNDA-1V2: NT2.1, U3.6 (GND)
GNDA-3V3: C5.2, NT1.1, U1.9 (GND)
unnamed: C1.1, JP1.2 (B), U1.5 (VIN)
unnamed: C5.1, U1.6 (EN), U1.7 (PS/SYNC), U1.8 (VINA)
unnamed: C12.1, JP3.2 (B), U3.2 (MODE), U3.4 (EN), U3.5 (VIN)
unnamed: JP2.1 (A), U1.1 (VOUT), U1.10 (FB)
unnamed: JP4.1 (A), L3.2, U3.3 (FB)
unnamed: L1.1, U1.4 (L1)
unnamed: L1.2, U1.2 (L2)
unnamed: L2.2, R1.2
unnamed: L3.1, U3.1 (SW)
unnamed: L4.2, R2.2

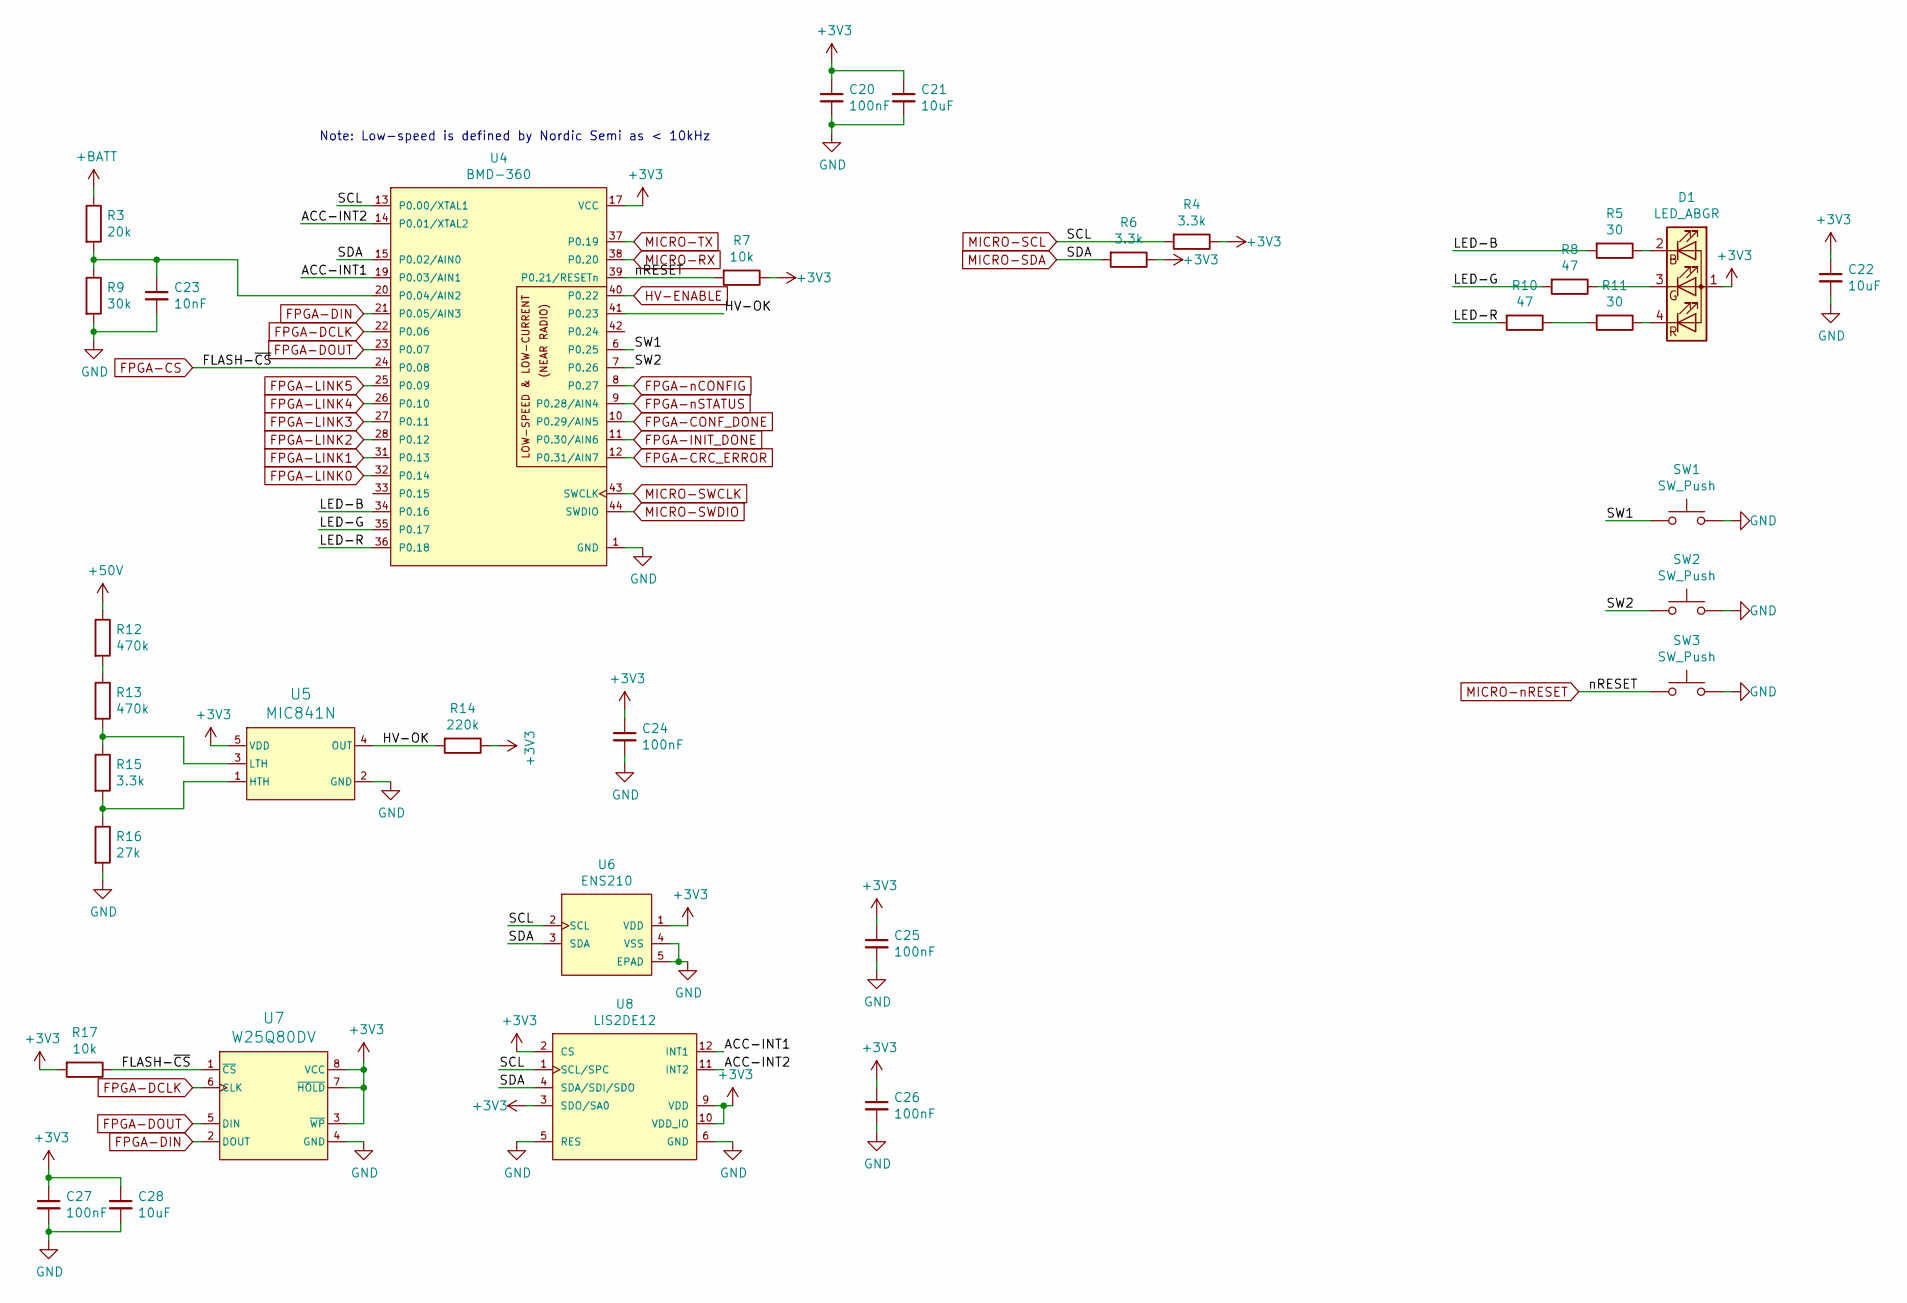
[picture p45: schematic Microcontroller.sch]

Parts:
C20, C24, C25, C26, C27: 100nF; C_0603_HandSoldering
C21, C22, C28: 10uF; C_0805_HandSoldering
C23: 10nF; C_0603_HandSoldering
D1: LED_ABGR; CLMVC-FKA
R3: 20k; R_0603_HandSoldering
R4, R6, R15: 3.3k; R_0603_HandSoldering
R5, R11: 30; R_0603_HandSoldering
R7, R17: 10k; R_0603_HandSoldering
R8, R10: 47; R_0603_HandSoldering
R9: 30k; R_0603_HandSoldering
R12, R13: 470k; R_0603_HandSoldering
R14: 220k; R_0603_HandSoldering
R16: 27k; R_0603_HandSoldering
SW1, SW2, SW3: SW_Push; PTS645SK43SM
U4: BMD-360
U5: MIC841N; SOT353
U6: ENS210; QFN4-PAD
U7: W25Q80DV; SOIC8
U8: LIS2DE12; LGA12

Connections:
+3V3: C20.1, C21.1, C22.1, C24.1, C25.1, C26.1, C27.1, C28.1, D1.1 (A), R4.1, R6.1, R7.1, R14.1, R17.2, U4.17 (VCC), U5.5 (VDD), U6.1 (VDD), U7.3 (~WP), U7.7 (~HOLD), U7.8 (VCC), U8.2 (CS), U8.3 (SDO/SA0), U8.9 (VDD), U8.10 (VDD_IO); also elsewhere on the board
+50V: R12.1; also elsewhere on the board
+BATT: R3.1; also elsewhere on the board
/Microcontroller/ACC-INT1: U4.19 (P0.03/AIN1), U8.12 (INT1)
/Microcontroller/ACC-INT2: U4.14 (P0.01/XTAL2), U8.11 (INT2)
/Microcontroller/HV-OK: R14.2, U4.41 (P0.23), U5.4 (OUT)
/Microcontroller/LED-B: R5.2, U4.34 (P0.16)
/Microcontroller/LED-G: R8.2, U4.35 (P0.17)
/Microcontroller/LED-R: R10.2, U4.36 (P0.18)
/Microcontroller/SW1: SW1.1, U4.6 (P0.25)
/Microcontroller/SW2: SW2.1, U4.7 (P0.26)
FPGA-CONF_DONE: U4.10 (P0.29/AIN5); also elsewhere on the board
FPGA-CRC_ERROR: U4.12 (P0.31/AIN7); also elsewhere on the board
FPGA-CS: R17.1, U4.24 (P0.08), U7.1 (~CS); also elsewhere on the board
FPGA-DCLK: U4.22 (P0.06), U7.6 (CLK); also elsewhere on the board
FPGA-DIN: U4.21 (P0.05/AIN3), U7.2 (DOUT); also elsewhere on the board
FPGA-DOUT: U4.23 (P0.07), U7.5 (DIN); also elsewhere on the board
FPGA-INIT_DONE: U4.11 (P0.30/AIN6); also elsewhere on the board
FPGA-LINK0: U4.32 (P0.14); also elsewhere on the board
FPGA-LINK1: U4.31 (P0.13); also elsewhere on the board
FPGA-LINK2: U4.28 (P0.12); also elsewhere on the board
FPGA-LINK3: U4.27 (P0.11); also elsewhere on the board
FPGA-LINK4: U4.26 (P0.10); also elsewhere on the board
FPGA-LINK5: U4.25 (P0.09); also elsewhere on the board
FPGA-nCONFIG: U4.8 (P0.27); also elsewhere on the board
FPGA-nSTATUS: U4.9 (P0.28/AIN4); also elsewhere on the board
GND: C20.2, C21.2, C22.2, C23.2, C24.2, C25.2, C26.2, C27.2, C28.2, R9.2, R16.2, SW1.2, SW2.2, SW3.2, U4.1 (GND), U4.2 (GND), U4.3 (GND), U4.4 (GND), U4.5 (GND), U4.16 (GND), U4.18 (GND), U4.29 (GND), U4.30 (GND), U4.45 (GND), U4.46 (GND), U4.47 (GND), U5.2 (GND), U6.4 (VSS), U6.5 (EPAD), U7.4 (GND), U8.5 (RES), U8.6 (GND), U8.7 (GND), U8.8 (GND); also elsewhere on the board
HV-ENABLE: U4.40 (P0.22); also elsewhere on the board
MICRO-RX: U4.38 (P0.20); also elsewhere on the board
MICRO-SCL: R4.2, U4.13 (P0.00/XTAL1), U6.2 (SCL), U8.1 (SCL/SPC); also elsewhere on the board
MICRO-SDA: R6.2, U4.15 (P0.02/AIN0), U6.3 (SDA), U8.4 (SDA/SDI/SDO); also elsewhere on the board
MICRO-SWCLK: U4.43 (SWCLK); also elsewhere on the board
MICRO-SWDIO: U4.44 (SWDIO); also elsewhere on the board
MICRO-TX: U4.37 (P0.19); also elsewhere on the board
MICRO-nRESET: R7.2, SW3.1, U4.39 (P0.21/RESETn); also elsewhere on the board
unnamed: C23.1, R3.2, R9.1, U4.20 (P0.04/AIN2)
unnamed: D1.2 (RK), R5.1
unnamed: D1.3 (GK), R8.1
unnamed: D1.4 (BK), R11.1
unnamed: R10.1, R11.2
unnamed: R12.2, R13.1
unnamed: R13.2, R15.1, U5.3 (LTH)
unnamed: R15.2, R16.1, U5.1 (HTH)

Notes on the sheet:
Note: Low-speed is defined by Nordic Semi as < 10kHz

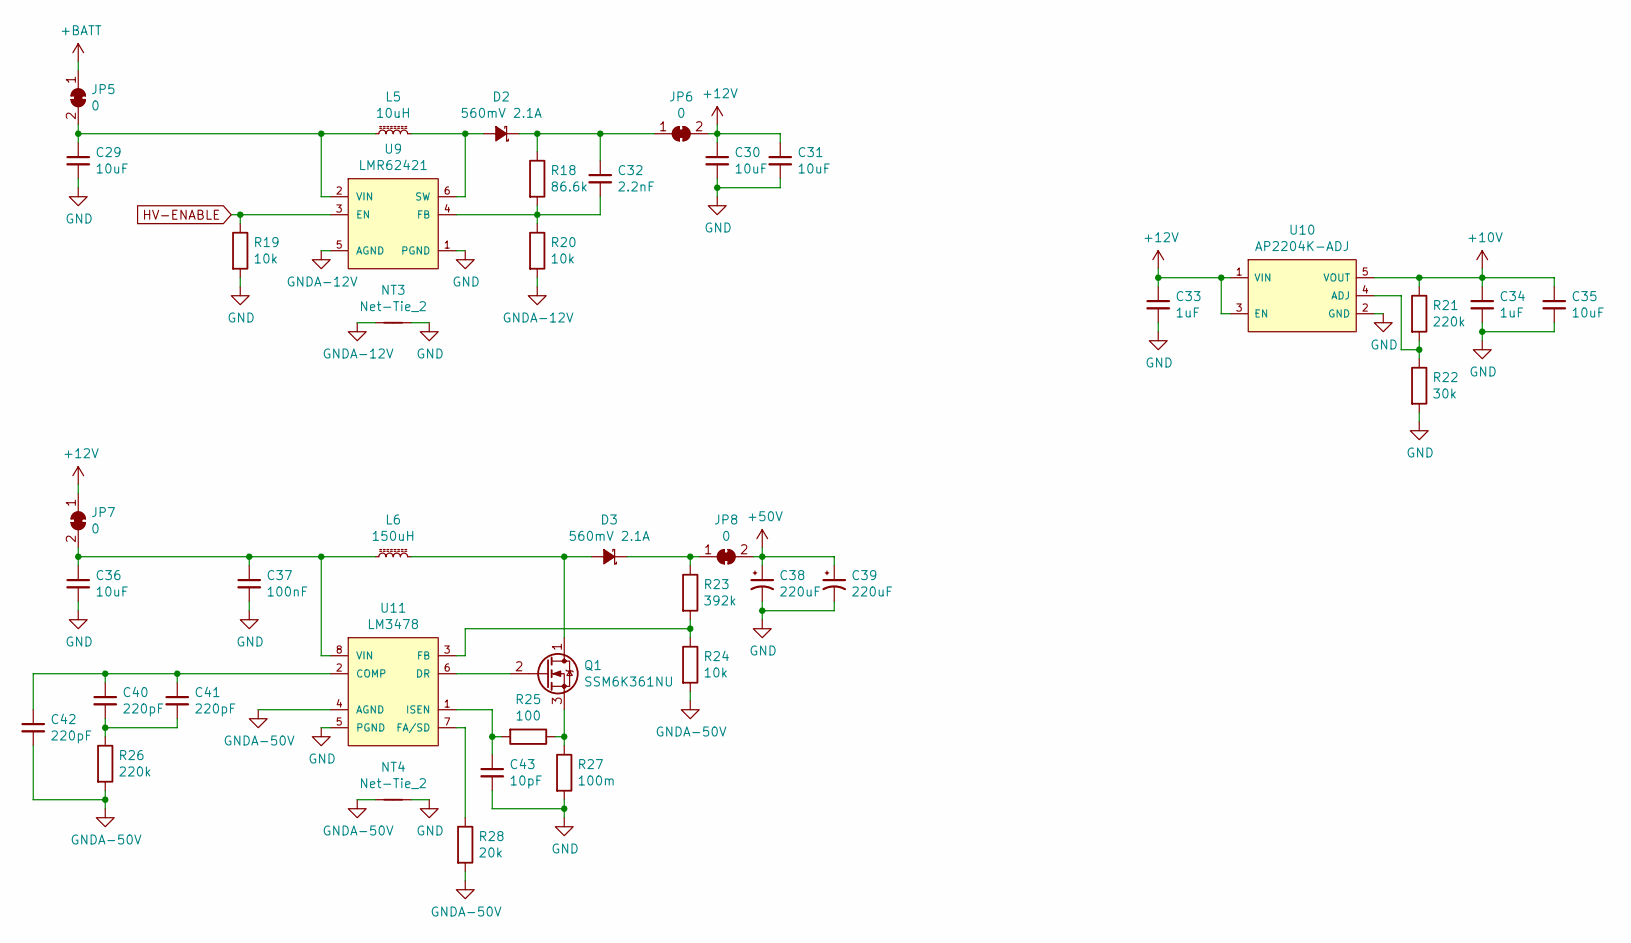
[picture p46: schematic HvPower.sch]

Parts:
C29: 10uF; C_0805_HandSoldering
C30, C31, C35, C36: 10uF; C_1206_HandSoldering
C32: 2.2nF; C_0603_HandSoldering
C33, C34: 1uF; C_0805_HandSoldering
C37: 100nF; C_0603_HandSoldering
C38, C39: 220uF; CP_Radial_D10.0mm_P5.00mm
C40, C41, C42: 220pF; C_0603_HandSoldering
C43: 10pF; C_0603_HandSoldering
D2, D3: 560mV 2.1A; DO-220AA
JP5, JP6, JP7, JP8: 0; SolderJumper_0603
L5: 10uH; NRS6045T100MMGK
L6: 150uH; SRU1048-151Y
NT3, NT4: Net-Tie_2; NetTie-2
Q1: SSM6K361NU; UDFN6-FET-PAD
R18: 86.6k; R_0603_HandSoldering
R19, R20, R24: 10k; R_0603_HandSoldering
R21, R26: 220k; R_0603_HandSoldering
R22: 30k; R_0603_HandSoldering
R23: 392k; R_0603_HandSoldering
R25: 100; R_0603_HandSoldering
R27: 100m; R_0603_HandSoldering
R28: 20k; R_0603_HandSoldering
U9: LMR62421; WSON6-3x3-PAD
U10: AP2204K-ADJ; SOT23-5
U11: LM3478; SSOP8

Connections:
+10V: C34.1, C35.1, R21.1, U10.5 (VOUT); also elsewhere on the board
+12V: C30.1, C31.1, C33.1, JP6.2 (B), JP7.1 (A), U10.1 (VIN), U10.3 (EN); also elsewhere on the board
+50V: C38.1, C39.1, JP8.2 (B); also elsewhere on the board
+BATT: JP5.1 (A); also elsewhere on the board
GND: C29.2, C30.2, C31.2, C33.2, C34.2, C35.2, C36.2, C37.2, C38.2, C39.2, C43.2, NT3.2, NT4.2, R19.2, R22.2, R27.2, U9.1 (PGND), U9.7 (EPAD), U10.2 (GND), U11.5 (PGND); also elsewhere on the board
GNDA-12V: NT3.1, R20.2, U9.5 (AGND)
GNDA-50V: C42.2, NT4.1, R24.2, R26.2, R28.2, U11.4 (AGND)
HV-ENABLE: R19.1, U9.3 (EN); also elsewhere on the board
unnamed: C29.1, JP5.2 (B), L5.1, U9.2 (VIN)
unnamed: C32.1, D2.1 (K), JP6.1 (A), R18.1
unnamed: C32.2, R18.2, R20.1, U9.4 (FB)
unnamed: C36.1, C37.1, JP7.2 (B), L6.1, U11.8 (VIN)
unnamed: C40.1, C41.1, C42.1, U11.2 (COMP)
unnamed: C40.2, C41.2, R26.1
unnamed: C43.1, R25.2, U11.1 (ISEN)
unnamed: D2.2 (A), L5.2, U9.6 (SW)
unnamed: D3.1 (K), JP8.1 (A), R23.1
unnamed: D3.2 (A), L6.2, Q1.1 (D)
unnamed: Q1.2 (G), U11.6 (DR)
unnamed: Q1.3 (S), R25.1, R27.1
unnamed: R21.2, R22.1, U10.4 (ADJ)
unnamed: R23.2, R24.1, U11.3 (FB)
unnamed: R28.1, U11.7 (FA/SD)

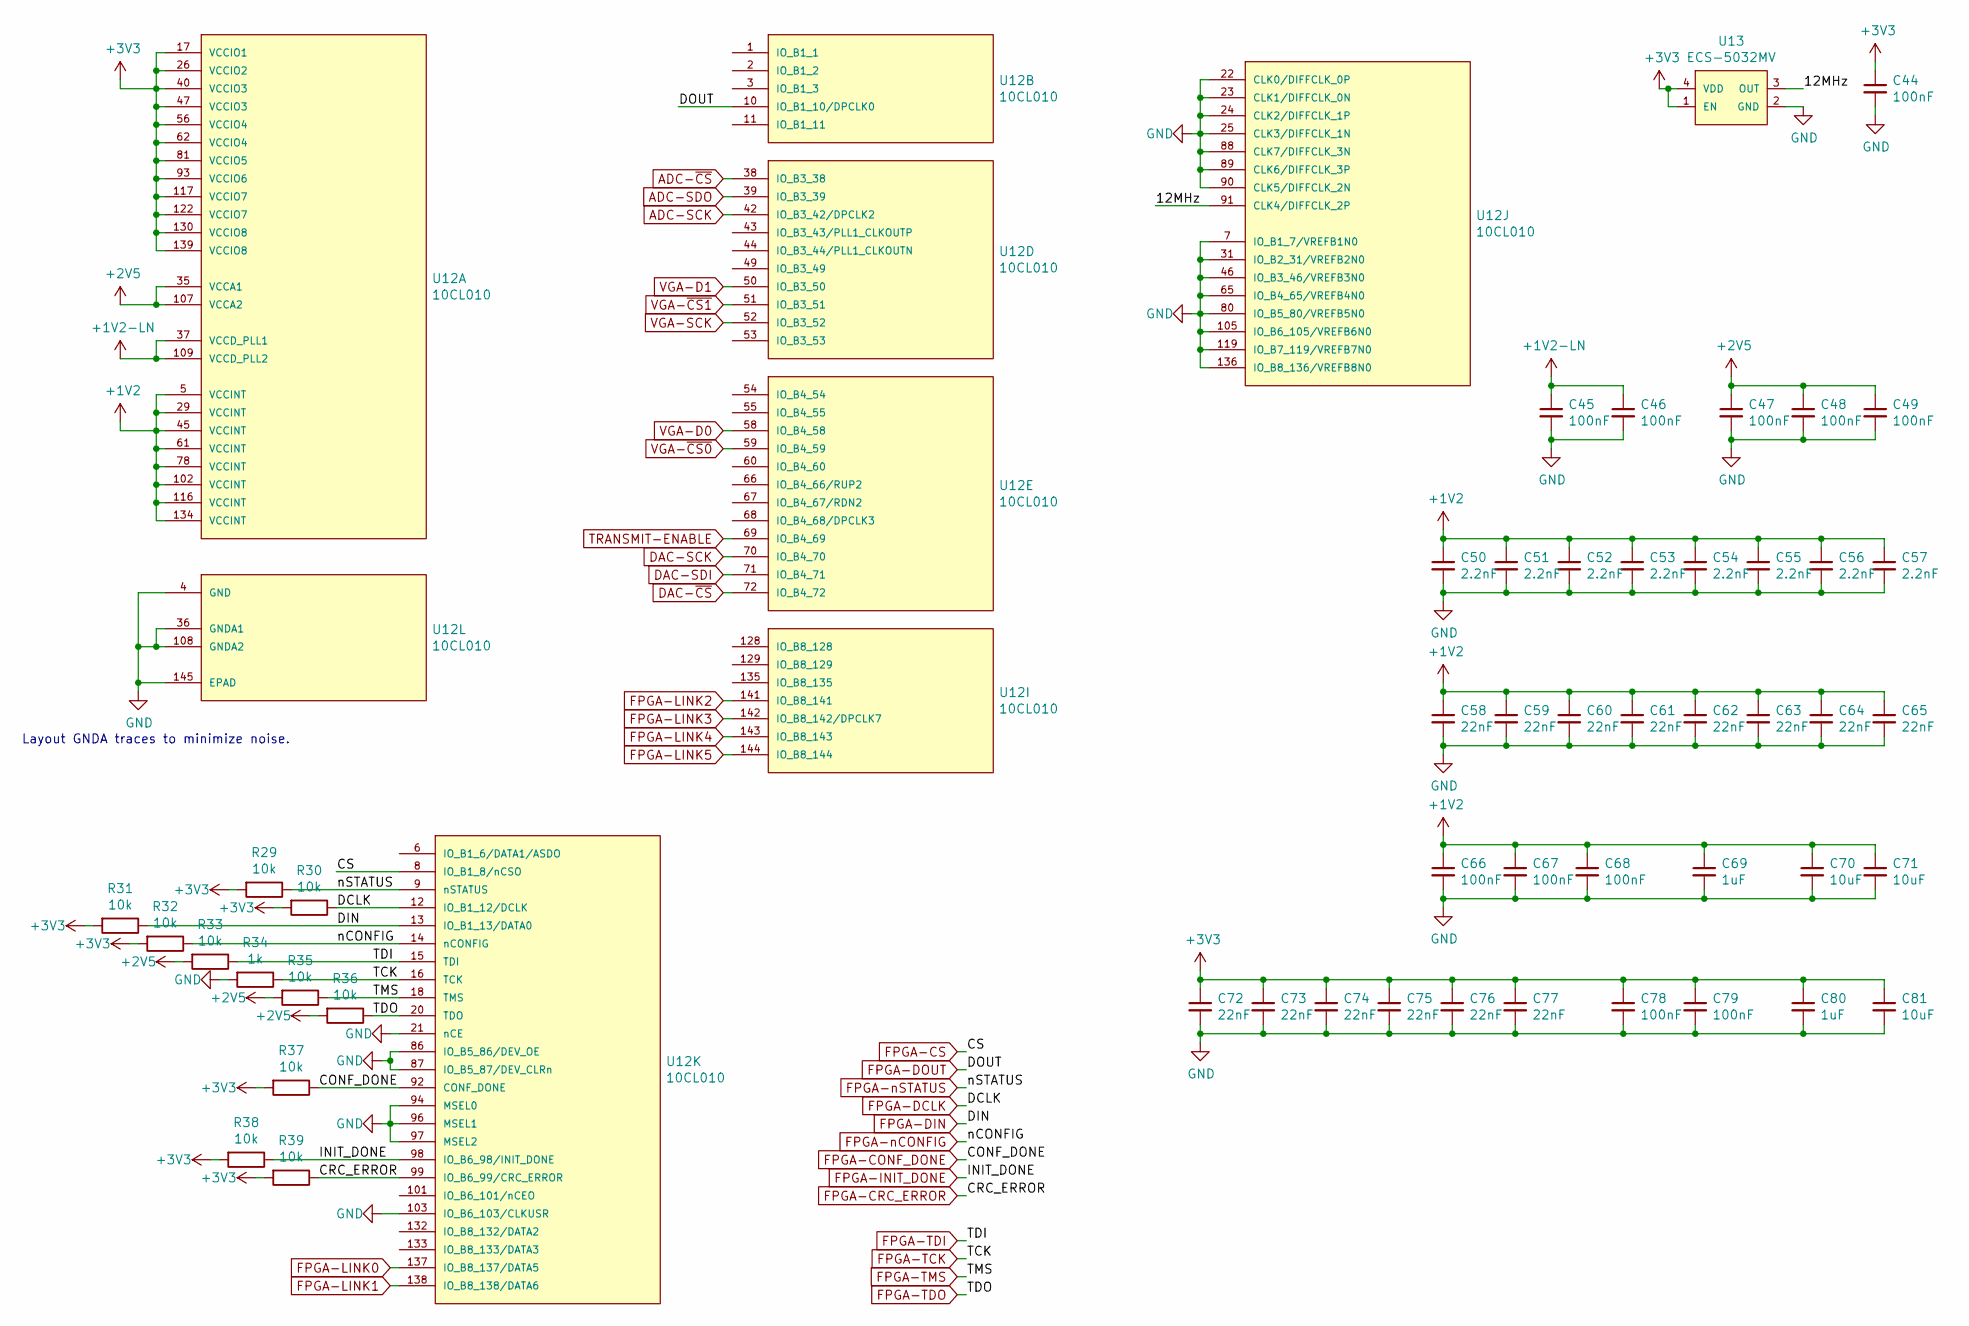
[picture p47: schematic Fpga.sch]

Parts:
C44, C45, C46, C47, C48, C49, C66, C67, C68, C78, C79: 100nF; C_0603_HandSoldering
C50, C51, C52, C53, C54, C55, C56, C57: 2.2nF; C_0603_HandSoldering
C58, C59, C60, C61, C62, C63, C64, C65, C72, C73, C74, C75, C76, C77: 22nF; C_0603_HandSoldering
C69, C80: 1uF; C_0603_HandSoldering
C70, C71, C81: 10uF; C_0805_HandSoldering
R29, R30, R31, R32, R33, R35, R36, R37, R38, R39: 10k; R_0603_HandSoldering
R34: 1k; R_0603_HandSoldering
U12: 10CL010; EQFP144-PAD
U13: ECS-5032MV

Connections:
+1V2: C50.1, C51.1, C52.1, C53.1, C54.1, C55.1, C56.1, C57.1, C58.1, C59.1, C60.1, C61.1, C62.1, C63.1, C64.1, C65.1, C66.1, C67.1, C68.1, C69.1, C70.1, C71.1, U12.5 (VCCINT), U12.29 (VCCINT), U12.45 (VCCINT), U12.61 (VCCINT), U12.78 (VCCINT), U12.102 (VCCINT), U12.116 (VCCINT), U12.134 (VCCINT); also elsewhere on the board
+1V2-LN: C45.1, C46.1, U12.37 (VCCD_PLL1), U12.109 (VCCD_PLL2); also elsewhere on the board
+2V5: C47.1, C48.1, C49.1, R33.2, R35.2, R36.2, U12.35 (VCCA1), U12.107 (VCCA2); also elsewhere on the board
+3V3: C44.1, C72.1, C73.1, C74.1, C75.1, C76.1, C77.1, C78.1, C79.1, C80.1, C81.1, R29.2, R30.2, R31.2, R32.2, R37.2, R38.2, R39.2, U12.17 (VCCIO1), U12.26 (VCCIO2), U12.40 (VCCIO3), U12.47 (VCCIO3), U12.56 (VCCIO4), U12.62 (VCCIO4), U12.81 (VCCIO5), U12.93 (VCCIO6), U12.117 (VCCIO7), U12.122 (VCCIO7), U12.130 (VCCIO8), U12.139 (VCCIO8), U13.1 (EN), U13.4 (VDD); also elsewhere on the board
/Fpga/12MHz: U12.91 (CLK4/DIFFCLK_2P), U13.3 (OUT)
ADC-SCK: U12.42 (IO_B3_42/DPCLK2); also elsewhere on the board
ADC-SDO: U12.39 (IO_B3_39); also elsewhere on the board
ADC-~CS: U12.38 (IO_B3_38); also elsewhere on the board
DAC-SCK: U12.70 (IO_B4_70); also elsewhere on the board
DAC-SDI: U12.71 (IO_B4_71); also elsewhere on the board
DAC-~CS: U12.72 (IO_B4_72); also elsewhere on the board
FPGA-CONF_DONE: R37.1, U12.92 (CONF_DONE); also elsewhere on the board
FPGA-CRC_ERROR: R39.1, U12.99 (IO_B6_99/CRC_ERROR); also elsewhere on the board
FPGA-CS: U12.8 (IO_B1_8/nCSO); also elsewhere on the board
FPGA-DCLK: R30.1, U12.12 (IO_B1_12/DCLK); also elsewhere on the board
FPGA-DIN: R31.1, U12.13 (IO_B1_13/DATA0); also elsewhere on the board
FPGA-DOUT: U12.10 (IO_B1_10/DPCLK0); also elsewhere on the board
FPGA-INIT_DONE: R38.1, U12.98 (IO_B6_98/INIT_DONE); also elsewhere on the board
FPGA-LINK0: U12.137 (IO_B8_137/DATA5); also elsewhere on the board
FPGA-LINK1: U12.138 (IO_B8_138/DATA6); also elsewhere on the board
FPGA-LINK2: U12.141 (IO_B8_141); also elsewhere on the board
FPGA-LINK3: U12.142 (IO_B8_142/DPCLK7); also elsewhere on the board
FPGA-LINK4: U12.143 (IO_B8_143); also elsewhere on the board
FPGA-LINK5: U12.144 (IO_B8_144); also elsewhere on the board
FPGA-TCK: R34.1, U12.16 (TCK); also elsewhere on the board
FPGA-TDI: R33.1, U12.15 (TDI); also elsewhere on the board
FPGA-TDO: R36.1, U12.20 (TDO); also elsewhere on the board
FPGA-TMS: R35.1, U12.18 (TMS); also elsewhere on the board
FPGA-nCONFIG: R32.1, U12.14 (nCONFIG); also elsewhere on the board
FPGA-nSTATUS: R29.1, U12.9 (nSTATUS); also elsewhere on the board
GND: C44.2, C45.2, C46.2, C47.2, C48.2, C49.2, C50.2, C51.2, C52.2, C53.2, C54.2, C55.2, C56.2, C57.2, C58.2, C59.2, C60.2, C61.2, C62.2, C63.2, C64.2, C65.2, C66.2, C67.2, C68.2, C69.2, C70.2, C71.2, C72.2, C73.2, C74.2, C75.2, C76.2, C77.2, C78.2, C79.2, C80.2, C81.2, R34.2, U12.4 (GND), U12.7 (IO_B1_7/VREFB1N0), U12.19 (GND), U12.21 (nCE), U12.22 (CLK0/DIFFCLK_0P), U12.23 (CLK1/DIFFCLK_0N), U12.24 (CLK2/DIFFCLK_1P), U12.25 (CLK3/DIFFCLK_1N), U12.27 (GND), U12.30 (GND), U12.31 (IO_B2_31/VREFB2N0), U12.36 (GNDA1), U12.41 (GND), U12.46 (IO_B3_46/VREFB3N0), U12.48 (GND), U12.57 (GND), U12.63 (GND), U12.64 (GND), U12.65 (IO_B4_65/VREFB4N0), U12.79 (GND), U12.80 (IO_B5_80/VREFB5N0), U12.82 (GND), U12.86 (IO_B5_86/DEV_OE), U12.87 (IO_B5_87/DEV_CLRn), U12.88 (CLK7/DIFFCLK_3N), U12.89 (CLK6/DIFFCLK_3P), U12.90 (CLK5/DIFFCLK_2N), U12.94 (MSEL0), U12.95 (GND), U12.96 (MSEL1), U12.97 (MSEL2), U12.103 (IO_B6_103/CLKUSR), U12.104 (GND), U12.105 (IO_B6_105/VREFB6N0), U12.108 (GNDA2), U12.110 (GND), U12.118 (GND), U12.119 (IO_B7_119/VREFB7N0), U12.123 (GND), U12.131 (GND), U12.136 (IO_B8_136/VREFB8N0), U12.140 (GND), U12.145 (EPAD), U13.2 (GND); also elsewhere on the board
TRANSMIT-ENABLE: U12.69 (IO_B4_69); also elsewhere on the board
VGA-D0: U12.58 (IO_B4_58); also elsewhere on the board
VGA-D1: U12.50 (IO_B3_50); also elsewhere on the board
VGA-SCK: U12.52 (IO_B3_52); also elsewhere on the board
VGA-~CS0: U12.59 (IO_B4_59); also elsewhere on the board
VGA-~CS1: U12.51 (IO_B3_51); also elsewhere on the board

Notes on the sheet:
Layout GNDA traces to minimize noise.

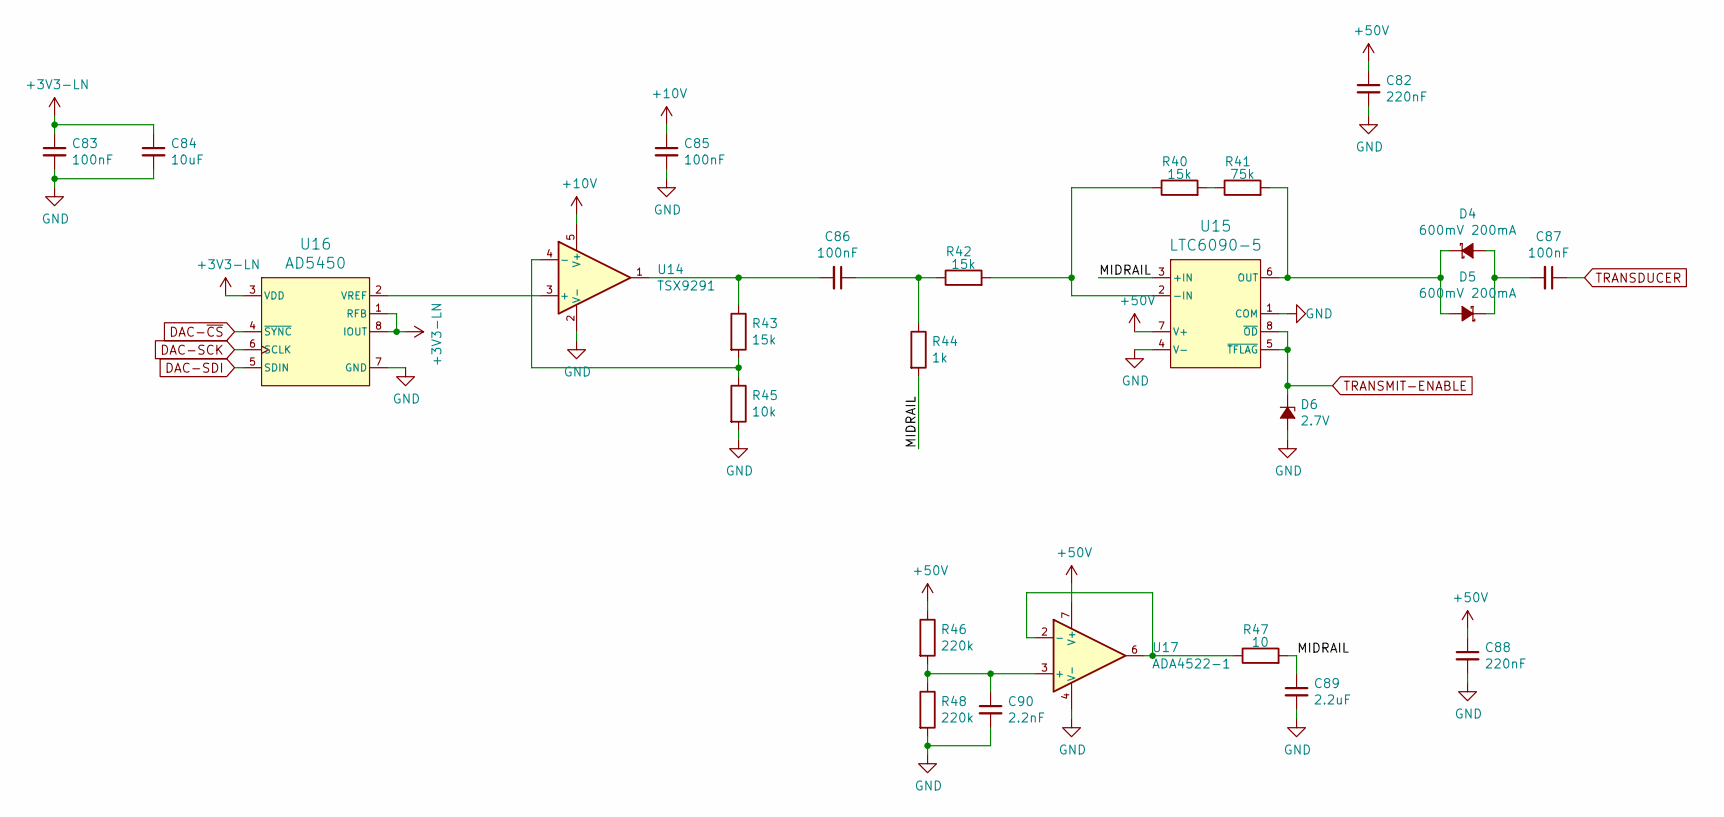
[picture p48: schematic Transmit.sch]

Parts:
C82, C88: 220nF; C_1206_HandSoldering
C83, C85: 100nF; C_0603_HandSoldering
C84: 10uF; C_0805_HandSoldering
C86, C87: 100nF; C_1206_HandSoldering
C89: 2.2uF; C_1206_HandSoldering
C90: 2.2nF; C_0603_HandSoldering
D4, D5: 600mV 200mA; D_SOD-523
D6: 2.7V; D_SOD-123
R40, R42, R43: 15k; R_0603_HandSoldering
R41: 75k; R_0603_HandSoldering
R44: 1k; R_0603_HandSoldering
R45: 10k; R_0603_HandSoldering
R46, R48: 220k; R_0603_HandSoldering
R47: 10; R_0603_HandSoldering
U14: TSX9291; SOT23-5
U15: LTC6090-5; SOIC8-PAD
U16: AD5450; TSOT8
U17: ADA4522-1; SSOP8

Connections:
+3V3-LN: C83.1, C84.1, U16.1 (RFB), U16.3 (VDD), U16.8 (IOUT); also elsewhere on the board
+10V: C85.1, U14.5 (V+); also elsewhere on the board
+50V: C82.1, C88.1, R46.1, U15.7 (V+), U17.7 (V+); also elsewhere on the board
/Transmit/MIDRAIL: C89.1, R44.2, R47.2, U15.3 (+IN)
DAC-SCK: U16.6 (SCLK); also elsewhere on the board
DAC-SDI: U16.5 (SDIN); also elsewhere on the board
DAC-~CS: U16.4 (~SYNC); also elsewhere on the board
GND: C82.2, C83.2, C84.2, C85.2, C88.2, C89.2, C90.2, D6.2 (A), R45.2, R48.2, U14.2 (V-), U15.1 (COM), U15.4 (V-), U15.9 (EPAD), U16.7 (GND), U17.4 (V-); also elsewhere on the board
unnamed: C86.1, R42.1, R44.1
unnamed: C86.2, R43.1, U14.1
unnamed: C87.2, D4.2 (A), D5.1 (K)
unnamed: C90.1, R46.2, R48.1, U17.3 (+)
unnamed: D4.1 (K), D5.2 (A), R41.2, U15.6 (OUT)
unnamed: R40.1, R42.2, U15.2 (-IN)
unnamed: R40.2, R41.1
unnamed: R43.2, R45.1, U14.4 (-)
unnamed: R47.1, U17.2 (-), U17.6
unnamed: U14.3 (+), U16.2 (VREF)
TRANSDUCER: C87.1; also elsewhere on the board
TRANSMIT-ENABLE: D6.1 (K), U15.5 (~TFLAG), U15.8 (~OD); also elsewhere on the board

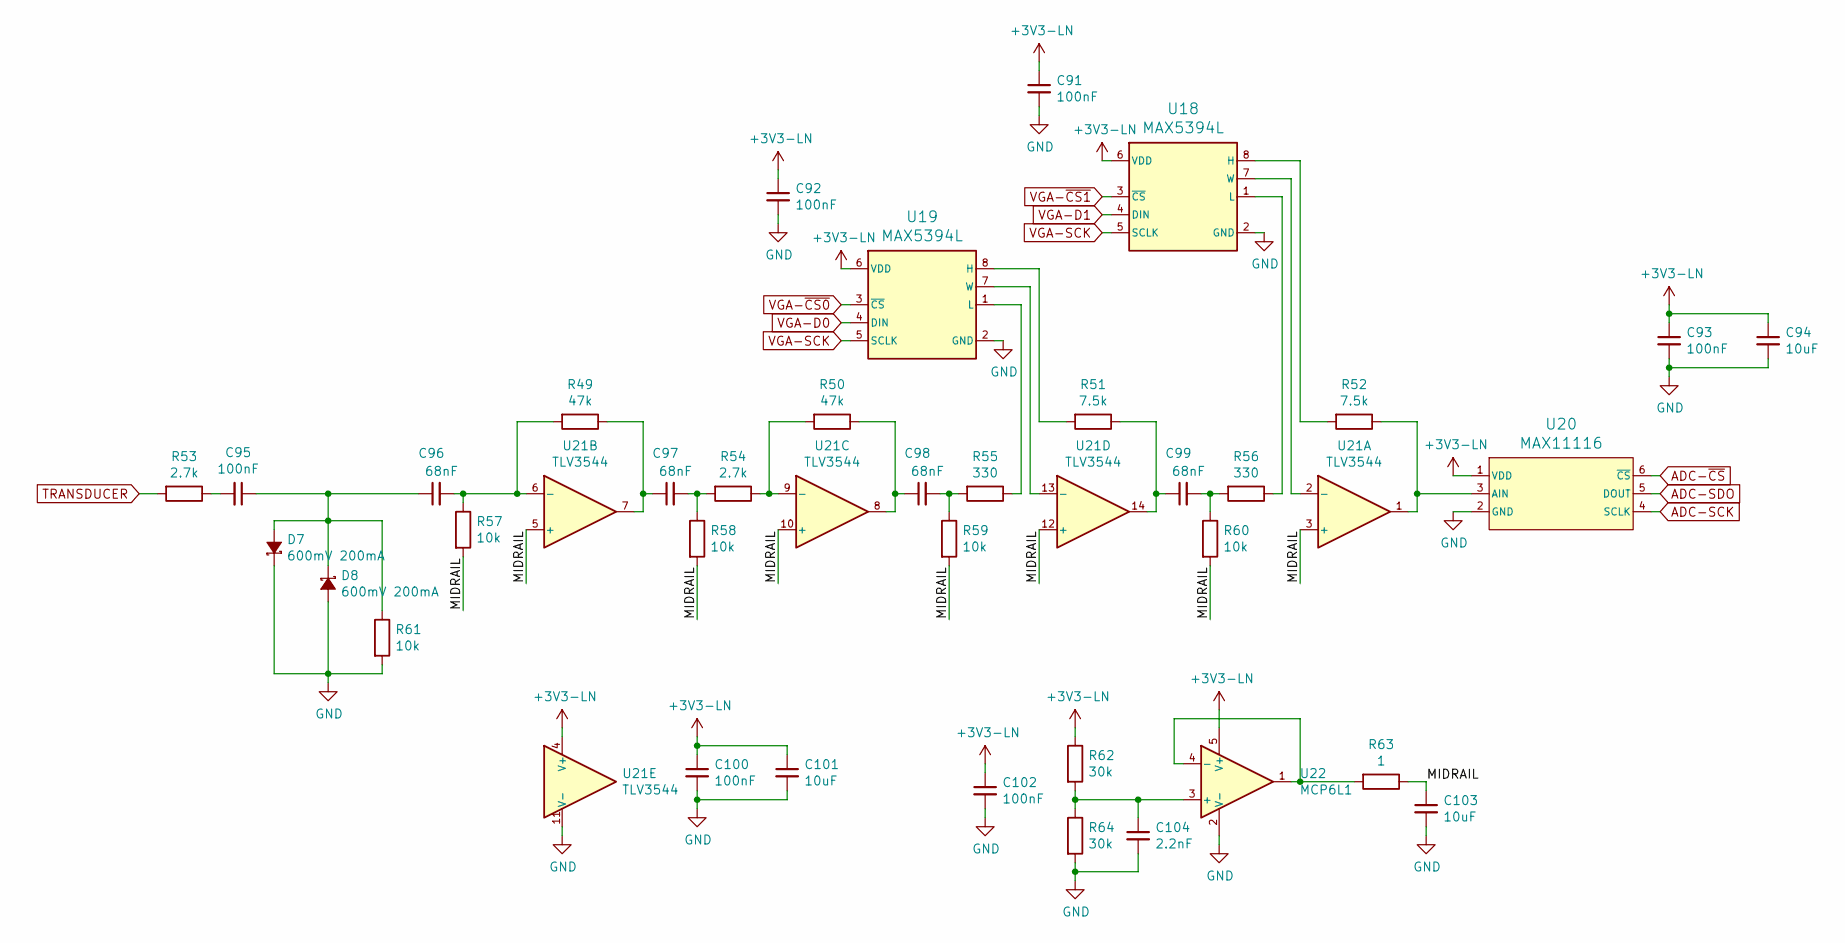
[picture p49: schematic Receive.sch]

Parts:
C91, C92, C93, C100, C102: 100nF; C_0603_HandSoldering
C94, C101, C103: 10uF; C_0805_HandSoldering
C95: 100nF; C_1206_HandSoldering
C96, C97, C98, C99: 68nF; C_0805_HandSoldering
C104: 2.2nF; C_0603_HandSoldering
D7, D8: 600mV 200mA; D_SOD-523
R49, R50: 47k; R_0603_HandSoldering
R51, R52: 7.5k; R_0603_HandSoldering
R53, R54: 2.7k; R_0603_HandSoldering
R55, R56: 330; R_0603_HandSoldering
R57, R58, R59, R60, R61: 10k; R_0603_HandSoldering
R62, R64: 30k; R_0603_HandSoldering
R63: 1; R_0603_HandSoldering
U18, U19: MAX5394L; TDFN8-PAD
U20: MAX11116; SOT23
U21: TLV3544; SSOP14
U22: MCP6L1; SOT23-5

Connections:
+3V3-LN: C91.1, C92.1, C93.1, C94.1, C100.1, C101.1, C102.1, R62.1, U18.6 (VDD), U19.6 (VDD), U20.1 (VDD), U21.4 (V+), U22.5 (V+); also elsewhere on the board
/Receive/MIDRAIL: C103.1, R57.2, R58.2, R59.2, R60.2, R63.1, U21.3 (+), U21.5 (+), U21.10 (+), U21.12 (+)
ADC-SCK: U20.4 (SCLK); also elsewhere on the board
ADC-SDO: U20.5 (DOUT); also elsewhere on the board
ADC-~CS: U20.6 (~CS); also elsewhere on the board
GND: C91.2, C92.2, C93.2, C94.2, C100.2, C101.2, C102.2, C103.2, C104.2, D7.1 (K), D8.2 (A), R61.2, R64.2, U18.2 (GND), U18.9 (EPAD), U19.2 (GND), U19.9 (EPAD), U20.2 (GND), U21.11 (V-), U22.2 (V-); also elsewhere on the board
unnamed: C95.1, C96.1, D7.2 (A), D8.1 (K), R61.1
unnamed: C95.2, R53.1
unnamed: C96.2, R49.2, R57.1, U21.6 (-)
unnamed: C97.1, R49.1, U21.7
unnamed: C97.2, R54.2, R58.1
unnamed: C98.1, R50.1, U21.8
unnamed: C98.2, R55.2, R59.1
unnamed: C99.1, R51.1, U21.14
unnamed: C99.2, R56.2, R60.1
unnamed: C104.1, R62.2, R64.1, U22.3 (+)
unnamed: R50.2, R54.1, U21.9 (-)
unnamed: R51.2, U19.8 (H)
unnamed: R52.1, U20.3 (AIN), U21.1
unnamed: R52.2, U18.8 (H)
unnamed: R55.1, U19.1 (L)
unnamed: R56.1, U18.1 (L)
unnamed: R63.2, U22.1, U22.4 (-)
unnamed: U18.7 (W), U21.2 (-)
unnamed: U19.7 (W), U21.13 (-)
TRANSDUCER: R53.2; also elsewhere on the board
VGA-D0: U19.4 (DIN); also elsewhere on the board
VGA-D1: U18.4 (DIN); also elsewhere on the board
VGA-SCK: U18.5 (SCLK), U19.5 (SCLK); also elsewhere on the board
VGA-~CS0: U19.3 (~CS); also elsewhere on the board
VGA-~CS1: U18.3 (~CS); also elsewhere on the board
