camerondm9/ece4600capstone/PCB/Capstone.kicad_pcb

## KiCad design PCB/Capstone.kicad_pcb (continued)

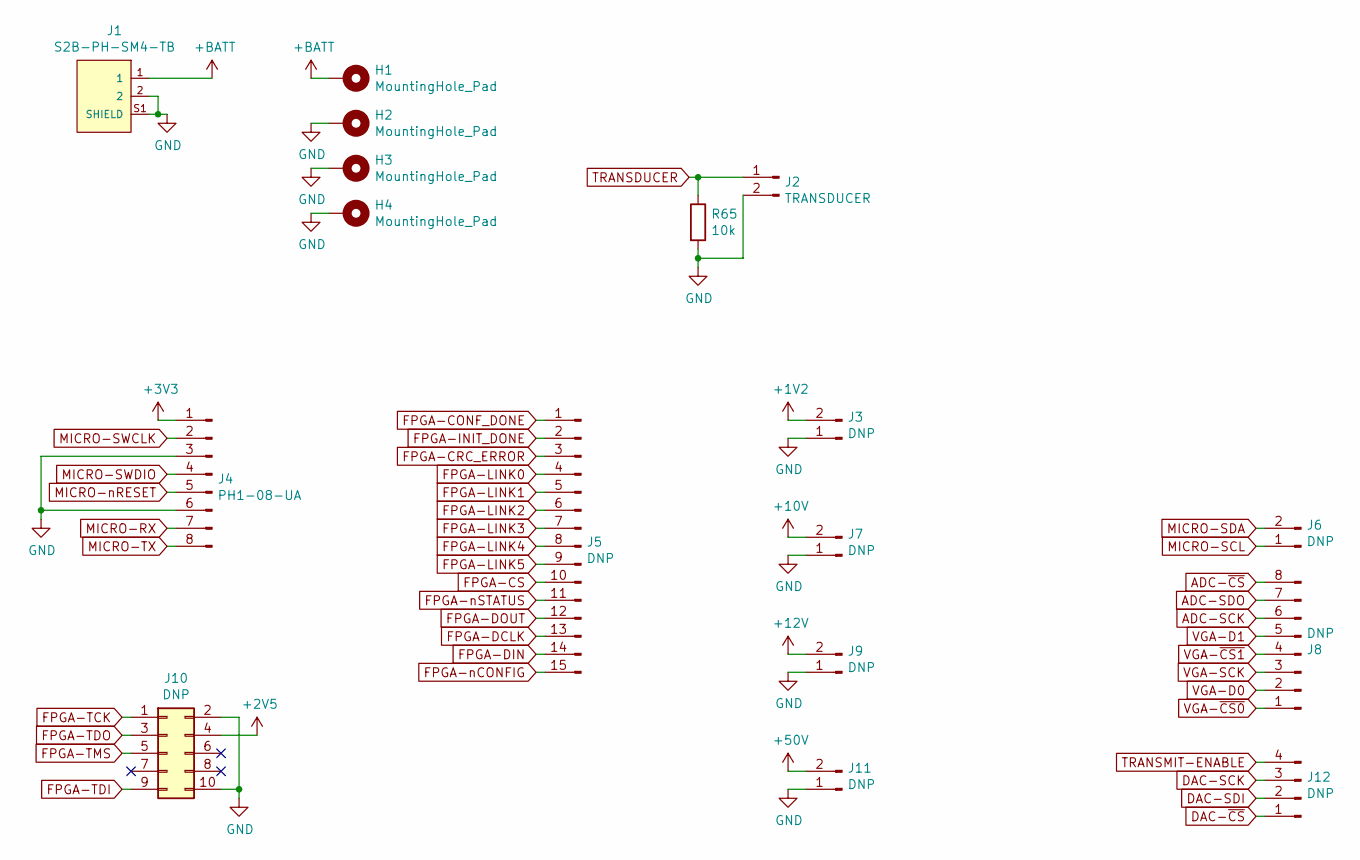
[picture p50: schematic Connectors.sch]

Parts:
H1, H2, H3, H4: MountingHole_Pad; MountingHole_4mm_Pad_Via
J1: S2B-PH-SM4-TB; JST_S2B-PH-SM4-TB
J2: TRANSDUCER; Pin_Header_Straight_1x02_Pitch2.54mm
J3, J6, J7, J9, J11: DNP; Pin_Header_Straight_1x02_Pitch2.54mm
J4: PH1-08-UA; Pin_Header_Straight_1x08_Pitch2.54mm
J5: DNP; Pin_Header_Straight_1x15_Pitch2.54mm
J8: DNP; Pin_Header_Straight_1x08_Pitch2.54mm
J10: DNP; Pin_Header_Straight_2x05_Pitch2.54mm
J12: DNP; Pin_Header_Straight_1x04_Pitch2.54mm
R65: 10k; R_1206_HandSoldering

Connections:
+1V2: J3.2; also elsewhere on the board
+2V5: J10.4; also elsewhere on the board
+3V3: J4.1; also elsewhere on the board
+10V: J7.2; also elsewhere on the board
+12V: J9.2; also elsewhere on the board
+50V: J11.2; also elsewhere on the board
+BATT: H1.1, J1.1; also elsewhere on the board
ADC-SCK: J8.6; also elsewhere on the board
ADC-SDO: J8.7; also elsewhere on the board
ADC-~CS: J8.8; also elsewhere on the board
DAC-SCK: J12.3; also elsewhere on the board
DAC-SDI: J12.2; also elsewhere on the board
DAC-~CS: J12.1; also elsewhere on the board
FPGA-CONF_DONE: J5.1; also elsewhere on the board
FPGA-CRC_ERROR: J5.3; also elsewhere on the board
FPGA-CS: J5.10; also elsewhere on the board
FPGA-DCLK: J5.13; also elsewhere on the board
FPGA-DIN: J5.14; also elsewhere on the board
FPGA-DOUT: J5.12; also elsewhere on the board
FPGA-INIT_DONE: J5.2; also elsewhere on the board
FPGA-LINK0: J5.4; also elsewhere on the board
FPGA-LINK1: J5.5; also elsewhere on the board
FPGA-LINK2: J5.6; also elsewhere on the board
FPGA-LINK3: J5.7; also elsewhere on the board
FPGA-LINK4: J5.8; also elsewhere on the board
FPGA-LINK5: J5.9; also elsewhere on the board
FPGA-TCK: J10.1; also elsewhere on the board
FPGA-TDI: J10.9; also elsewhere on the board
FPGA-TDO: J10.3; also elsewhere on the board
FPGA-TMS: J10.5; also elsewhere on the board
FPGA-nCONFIG: J5.15; also elsewhere on the board
FPGA-nSTATUS: J5.11; also elsewhere on the board
GND: H2.1, H3.1, H4.1, J1.2, J1.S1 (SHIELD), J1.S2 (SHIELD), J2.2, J3.1, J4.3, J4.6, J7.1, J9.1, J10.2, J10.10, J11.1, R65.2; also elsewhere on the board
MICRO-RX: J4.7; also elsewhere on the board
MICRO-SCL: J6.1; also elsewhere on the board
MICRO-SDA: J6.2; also elsewhere on the board
MICRO-SWCLK: J4.2; also elsewhere on the board
MICRO-SWDIO: J4.4; also elsewhere on the board
MICRO-TX: J4.8; also elsewhere on the board
MICRO-nRESET: J4.5; also elsewhere on the board
TRANSDUCER: J2.1, R65.1; also elsewhere on the board
TRANSMIT-ENABLE: J12.4; also elsewhere on the board
VGA-D0: J8.2; also elsewhere on the board
VGA-D1: J8.5; also elsewhere on the board
VGA-SCK: J8.3; also elsewhere on the board
VGA-~CS0: J8.1; also elsewhere on the board
VGA-~CS1: J8.4; also elsewhere on the board

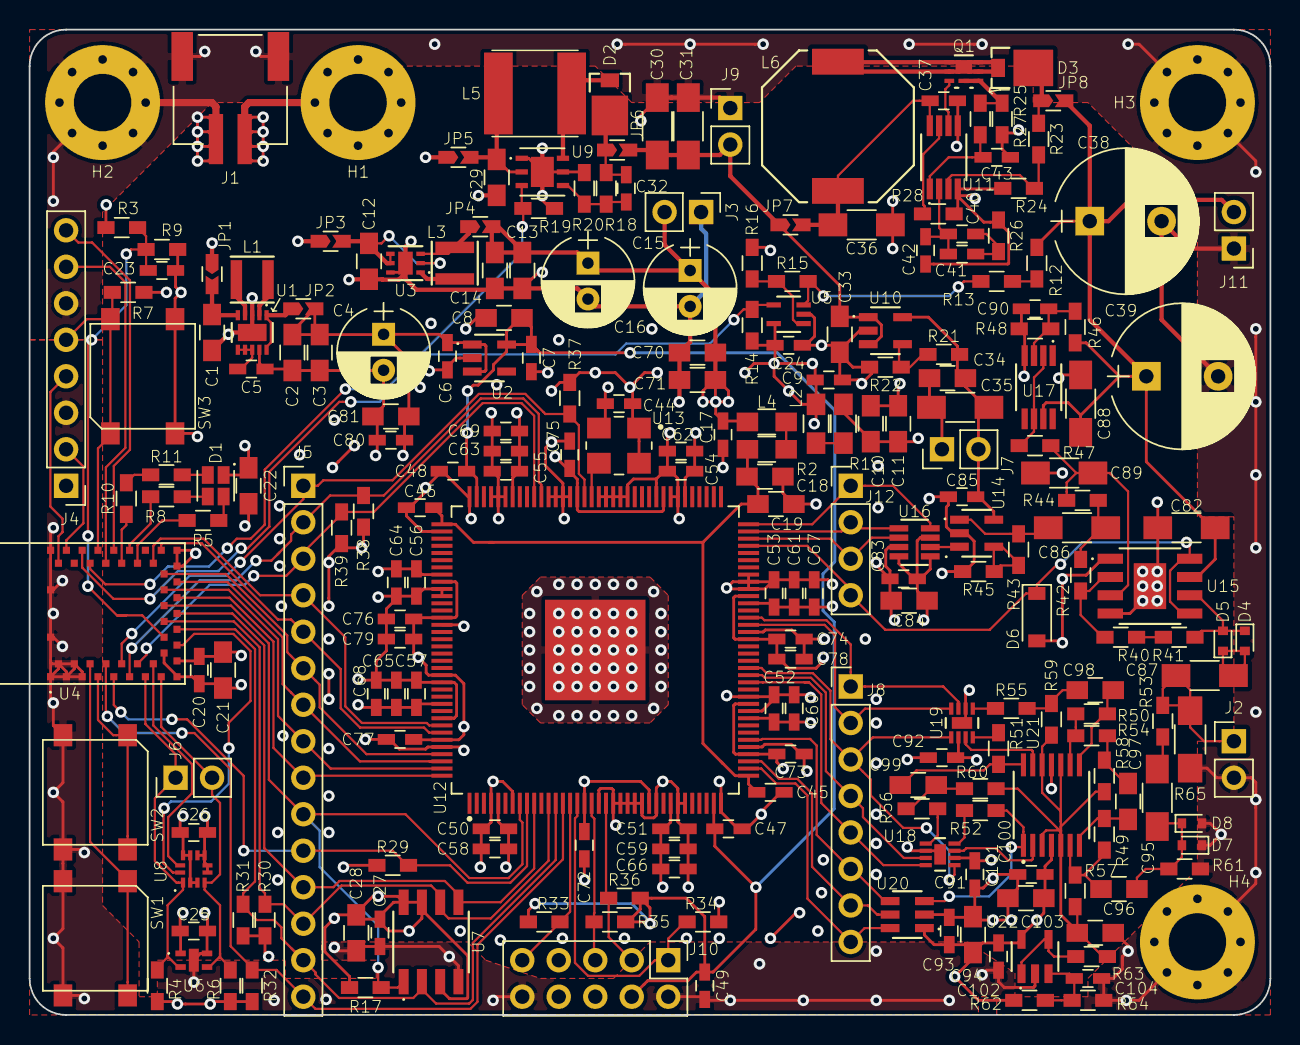
[picture p51: board Capstone.kicad_pcb from above]

Board: 4 copper layers, 86.4 x 68.6 mm, 238 parts (1 on the bottom side), 127 nets.

Other parts of the board:
Ref**: Val**; BottomLogo
