camerondm9/ece4600capstone/Microcontroller/main.c

#include <stdio.h>
#include <stdlib.h>
#include "uart.h"
#include "spi.h"
#include "radio.h"
#include <nrf.h>

typedef enum STATES
{
	STATE_STARTUP = 0,
	STATE_READY,
	STATE_ADVERTISING,
	STATE_SLAVE,
	STATE_SEARCHING,
	STATE_MASTER,
	STATE_DOWNLOAD,
} STATES;

volatile STATES main_state = STATE_STARTUP;


void clock_init(void) {
	//Start HFCLK... (required to use radio)
	NRF_CLOCK->EVENTS_HFCLKSTARTED = 0;
	NRF_CLOCK->TASKS_HFCLKSTART = 1;
	while (NRF_CLOCK->EVENTS_HFCLKSTARTED == 0) {}
	NRF_CLOCK->EVENTS_HFCLKSTARTED = 0;
}


//TODO: fpga_test_bitstream
void fpga_test_transfer();
//TODO: fpga_test_bitstream


void main(void)
{
	//TODO: Make sure interrupts are disabled here, if they could cause a problem.
	//Alternatively, initialize the peripherals in the right order, that problems cannot happen.

	__disable_irq();
	//Initialize peripherals...
	clock_init();
	uart_init();
	spi_init();

	__enable_irq();


	printf("Initialization complete. Entering pairing mode\n");
/*
	SpiTransfer* tx1 = queue_dequeue(&spi_emq);
	tx1->flags = SPI_FLAG_FPGA | SPI_FLAG_INLINE | SPI_FLAG_WRITE;
	tx1->length = 2;
	tx1->next = NULL;
	tx1->buffer[0] = 0xF1;
	tx1->buffer[1] = 0x8F;
	spi_transfer(tx1);

	for (volatile int i = 0; i < 100000000; i++) {}

	SpiTransfer* tx2 = queue_dequeue(&spi_emq);
	tx2->flags = SPI_FLAG_FLASH | SPI_FLAG_INLINE | SPI_FLAG_WRITE;
	tx2->length = 2;
	tx2->next = NULL;
	tx2->buffer[0] = 0xF1;
	tx2->buffer[1] = 0x8F;
	spi_transfer(tx2);
*/

	radio_run_test();

	//TODO: Begin FPGA test code
	fpga_test_transfer();
	//TODO: End FPGA test code

	while (1)
	{
		int idle = 1;
		UartPacket* packet = queue_dequeue(&uart_rxq);
		if (packet)
		{
			idle = 0;
			if (uart_check_crc(packet))
			{
				//Echo...
				uart_transmit(packet);
			}
			else
			{
				queue_enqueue(&uart_emq, packet);
			}
		}
		switch (main_state)
		{
		case STATE_STARTUP:

			break;
		case STATE_ADVERTISING:

			break;
		case STATE_SLAVE:

			break;
		case STATE_SEARCHING:

			break;
		case STATE_MASTER:

			break;
		case STATE_DOWNLOAD:

			break;
		default:

			break;
		}
		if (idle)
		{
			//Wait for an interrupt/event...
			__WFE();
		}
	}
}

//TODO: Setup state machine:
// - Pairing mode (default, at startup)
// - Slave mode (after master-initiated pairing)
// - Master mode (activated by "master mode" UART packet from computer)
//There will be many sub-states...

//TODO: State machine will control FPGA configuration, HV power status
