camerondm9/ece4600capstone/Microcontroller/uart.c

#include "uart.h"
#include "pins.h"
#include "crc.h"
#include <string.h>
#include <stddef.h>
#include <nrf.h>

// CRC error correction function
// Capable of correction 1-bit errors, and detecting 2-bit and 3-bit errors
static const uint8_t length_correction_crc8_table[256] = {
	0xFFU, 0xFFU, 0x01U, 0xFFU, 0x02U, 0xFFU, 0xFFU, 0xFFU,
	0x04U, 0xFFU, 0xFFU, 0xFFU, 0xFFU, 0xFFU, 0xFFU, 0xFFU,
	0x08U, 0xFFU, 0xFFU, 0xFFU, 0xFFU, 0xFFU, 0xFFU, 0xFFU,
	0xFFU, 0xFFU, 0xFFU, 0xFFU, 0xFFU, 0xFFU, 0xFFU, 0xFFU,
	0x10U, 0xFFU, 0xFFU, 0xFFU, 0xFFU, 0xFFU, 0xFFU, 0xFFU,
	0xFFU, 0xFFU, 0xFFU, 0xFFU, 0xFFU, 0xFFU, 0xFFU, 0xFFU,
	0xFFU, 0xFFU, 0xFFU, 0x00U, 0xFFU, 0xFFU, 0xFFU, 0xFFU,
	0xFFU, 0xFFU, 0xFFU, 0xFFU, 0xFFU, 0xFFU, 0xFFU, 0xFFU,
	0x20U, 0xFFU, 0xFFU, 0xFFU, 0xFFU, 0xFFU, 0xFFU, 0xFFU,
	0xFFU, 0xFFU, 0xFFU, 0xFFU, 0xFFU, 0xFFU, 0xFFU, 0x00U,
	0xFFU, 0xFFU, 0xFFU, 0xFFU, 0xFFU, 0xFFU, 0xFFU, 0xFFU,
	0xFFU, 0xFFU, 0xFFU, 0xFFU, 0xFFU, 0xFFU, 0xFFU, 0xFFU,
	0xFFU, 0xFFU, 0xFFU, 0xFFU, 0xFFU, 0xFFU, 0x00U, 0xFFU,
	0xFFU, 0xFFU, 0xFFU, 0xFFU, 0xFFU, 0xFFU, 0xFFU, 0xFFU,
	0xFFU, 0xFFU, 0xFFU, 0xFFU, 0xFFU, 0xFFU, 0xFFU, 0xFFU,
	0xFFU, 0x00U, 0xFFU, 0xFFU, 0xFFU, 0xFFU, 0xFFU, 0xFFU,
	0x40U, 0xFFU, 0xFFU, 0xFFU, 0xFFU, 0xFFU, 0xFFU, 0xFFU,
	0xFFU, 0xFFU, 0xFFU, 0xFFU, 0xFFU, 0xFFU, 0xFFU, 0xFFU,
	0xFFU, 0xFFU, 0xFFU, 0xFFU, 0xFFU, 0xFFU, 0xFFU, 0xFFU,
	0xFFU, 0xFFU, 0xFFU, 0xFFU, 0xFFU, 0xFFU, 0x00U, 0xFFU,
	0xFFU, 0xFFU, 0xFFU, 0xFFU, 0xFFU, 0xFFU, 0xFFU, 0xFFU,
	0xFFU, 0xFFU, 0xFFU, 0xFFU, 0xFFU, 0xFFU, 0xFFU, 0xFFU,
	0xFFU, 0xFFU, 0xFFU, 0xFFU, 0xFFU, 0xFFU, 0xFFU, 0xFFU,
	0xFFU, 0xFFU, 0xFFU, 0xFFU, 0xFFU, 0xFFU, 0xFFU, 0xFFU,
	0xFFU, 0xFFU, 0xFFU, 0xFFU, 0xFFU, 0xFFU, 0xFFU, 0xFFU,
	0xFFU, 0xFFU, 0xFFU, 0xFFU, 0x00U, 0xFFU, 0xFFU, 0xFFU,
	0xFFU, 0xFFU, 0xFFU, 0xFFU, 0xFFU, 0xFFU, 0xFFU, 0x80U,
	0xFFU, 0xFFU, 0xFFU, 0xFFU, 0xFFU, 0xFFU, 0xFFU, 0xFFU,
	0xFFU, 0xFFU, 0xFFU, 0xFFU, 0xFFU, 0xFFU, 0xFFU, 0xFFU,
	0xFFU, 0xFFU, 0xFFU, 0x00U, 0xFFU, 0xFFU, 0xFFU, 0xFFU,
	0xFFU, 0xFFU, 0x00U, 0xFFU, 0xFFU, 0xFFU, 0xFFU, 0xFFU,
	0xFFU, 0xFFU, 0xFFU, 0xFFU, 0xFFU, 0xFFU, 0xFFU, 0xFFU,
};
static uint8_t* uart_detect_packet(uint8_t* buffer, int buffer_count)
{
	buffer_count -= 2;
	while (buffer_count > 0)
	{
		uint8_t error = buffer[0] ^ 0xCA;
		error &= error - 1;
		if (error == 0)
		{
			//Potential sync byte...
			error = crc8_single(buffer[2], crc8_single(buffer[1], 0xFF));
			if (error == 0)
			{
				//Found packet...
				return buffer;
			}
			//CRC invalid, attempt correction...
			error = length_correction_crc8_table[error];
			if (error != 0xFF)
			{
				buffer[1] ^= error;
				return buffer;
			}
		}
		buffer++;
		buffer_count--;
	}
	return NULL;
}

uint32_t uart_errors_framing = 0;
uint32_t uart_errors_overrun = 0;
uint32_t uart_errors_sync = 0;
uint32_t uart_errors_crc = 0;

Queue uart_txq = QUEUE(8);
Queue uart_rxq = QUEUE(8);
Queue uart_emq = QUEUE(32);

static UartPacket uart_packets[18]; //TODO: Can we shrink the size of the queues? That would allow us to reserve less space for packets, and use less of our (precious) RAM...
                                    //TODO: Alternate option: receive UART into a large buffer, slicing it into packets as we go... (more complex, but would allow lots of small packets without using as much RAM)

static UartPacket* volatile uart_tx_packet = NULL;
static UartPacket* volatile uart_rx_packet = NULL;
static volatile uint32_t uart_rx_state = 0;

#define UART_PACKET_HEADER_SIZE (8)

void uart_init()
{
	//Use a queue to track empty buffers...
	for (int i = sizeof(uart_packets)/sizeof(*uart_packets) - 1; i >= 0; i--)
	{
		queue_enqueue(&uart_emq, &uart_packets[i]);
	}
	uart_rx_packet = queue_dequeue(&uart_emq);
	//Configure pins...
	NRF_P0->PIN_CNF[PIN_MICRO_TX] = 0x0030F; //sense disabled, high drive, pull-up, output
	NRF_P0->PIN_CNF[PIN_MICRO_RX] = 0x0000C; //sense disabled, standard drive, pull-up, input
	//Configure UART...
	NRF_UARTE0->SHORTS = 0;
	NRF_UARTE0->INTEN = 0x00000310; //ERROR, ENDTX, ENDRX
	NRF_UARTE0->PSEL.CTS = 0x80000000; //not connected
	NRF_UARTE0->PSEL.RTS = 0x80000000; //not connected
	NRF_UARTE0->PSEL.RXD = PIN_MICRO_RX;
	NRF_UARTE0->PSEL.TXD = PIN_MICRO_TX;
	NRF_UARTE0->BAUDRATE = 0x03B00000; //230400 baud
	NRF_UARTE0->RXD.PTR = (uint32_t)uart_rx_packet;
	NRF_UARTE0->RXD.MAXCNT = UART_PACKET_HEADER_SIZE;
	NRF_UARTE0->TXD.PTR = NULL;
	NRF_UARTE0->TXD.MAXCNT = 0;
	NRF_UARTE0->CONFIG = 0; //1 stop-bit, parity disabled, flow-control disabled
	NVIC_EnableIRQ(UARTE0_UART0_IRQn);
	NRF_UARTE0->ENABLE = 8;
	NRF_UARTE0->TASKS_STARTRX = 1;
}

static void uart_transmit_next()
{
	UartPacket* packet = queue_dequeue(&uart_txq);
	uart_tx_packet = packet;
	if (packet)
	{
		NRF_UARTE0->TXD.PTR = (uint32_t)(packet->raw);
		NRF_UARTE0->TXD.MAXCNT = (9 + packet->length[0]);
		NRF_UARTE0->TASKS_STARTTX = 1;
	}
}

int uart_check_crc(UartPacket* packet)
{
	uint8_t length = packet->length[0];
	return crc16(packet->payload, 3 + length, 0xFFFF) == *(uint16_t*)(&packet->payload[3 + length]);
}

int uart_transmit(UartPacket* packet)
{
	//Prepare packet for transmission...
	packet->sync[0] = 0xFF;
	packet->sync[1] = 0xCA;
	uint8_t length = packet->length[0];
	packet->length[1] = crc8_single(length, 0xFF);
	*(uint16_t*)(&packet->payload[3 + length]) = crc16(packet->payload, 3 + length, 0xFFFF); //TODO: Does this work?
	//Place packet in queue...
	if (queue_enqueue(&uart_txq, packet))
	{
		if (uart_tx_packet == NULL)
		{
			uart_transmit_next();
		}
		return 1;
	}
	return 0;
}

void UARTE0_UART0_IRQHandler(void)
{
	if (NRF_UARTE0->EVENTS_ERROR)
	{
		NRF_UARTE0->EVENTS_ERROR = 0;
		//Get error flags and reset them...
		uint32_t errors = NRF_UARTE0->ERRORSRC;
		NRF_UARTE0->ERRORSRC = errors;
		if (errors & 1)
		{
			//Overrun error...
			uart_errors_overrun++;
		}
		//Parity errors are impossible, since the parity bit is not used.
		if (errors & 4)
		{
			//Framing error...
			uart_errors_framing++;
		}
		if (errors & 8)
		{
			//Break error...

			//TODO: Adding support for this would allow us to abort packet transmission partway through, and keep the receiver synchronized.
			//That seems like a very unlikely course of action, so this is probably not important to implement...
		}
	}
	if (NRF_UARTE0->EVENTS_ENDTX)
	{
		NRF_UARTE0->EVENTS_ENDTX = 0;
		//Packet was transmitted, can be reused...
		queue_enqueue(&uart_emq, uart_tx_packet);
		//Start transmission of next packet... (if queue not empty)
		uart_transmit_next();
	}
	if (NRF_UARTE0->EVENTS_ENDRX)
	{
		NRF_UARTE0->EVENTS_ENDRX = 0;
		if (uart_rx_state)
		{
			//Packet is complete...
complete:	if (queue_enqueue(&uart_rxq, uart_rx_packet))
			{
				uart_rx_packet = queue_dequeue(&uart_emq);
			}
			//Receive next packet...
			uart_rx_state = 0;
			NRF_UARTE0->RXD.PTR = (uint32_t)uart_rx_packet;
			NRF_UARTE0->RXD.MAXCNT = UART_PACKET_HEADER_SIZE;
		}
		else
		{
			//Scan for header...
			UartPacket* p = uart_rx_packet;
			uint8_t* h = uart_detect_packet(p->raw, UART_PACKET_HEADER_SIZE);
			if (h)
			{
				uint32_t offset = h - p->raw;
				uint32_t length = UART_PACKET_HEADER_SIZE - offset;
				if (offset != 1)
				{
                    uart_errors_sync++;
					memmove(p->raw + 1, h, length);
				}
				//Check for full packet...
				uint32_t remaining = p->length[0] + offset;
				if (remaining == 0)
				{
					goto complete;
				}
				//Receive rest of packet...
				uart_rx_state = 1;
				NRF_UARTE0->RXD.PTR = (uint32_t)(p->raw + 1 + length);
				NRF_UARTE0->RXD.MAXCNT = remaining;
			}
			else
			{
                uart_errors_sync++;
				memmove(p->raw, p->raw + 6, 2);
				//Continue search for header...
				NRF_UARTE0->RXD.PTR = (uint32_t)(p->raw + 2);
				NRF_UARTE0->RXD.MAXCNT = UART_PACKET_HEADER_SIZE - 2;
			}
		}
		NRF_UARTE0->TASKS_STARTRX = 1;
	}
}
