camerondm9/ece4600capstone/Microcontroller/radio.h

#pragma once

#include <stdint.h>
#include "queue.h"

typedef struct RadioPacket
{
	uint8_t length;
	uint8_t payload[63];
} RadioPacket;

void radio_init();
void radio_test_loop();
void radio_run_test();
