camerondm9/ece4600capstone/FPGA/internal_osc.v

//internal_osc CBX_AUTO_BLACKBOX="ALL" CBX_SINGLE_OUTPUT_FILE="ON" DEVICE_FAMILY="Cyclone 10 LP" clkout oscena
//VERSION_BEGIN 18.1 cbx_internal_osc 2018:09:12:13:04:24:SJ cbx_arriav 2018:09:12:13:04:23:SJ cbx_cycloneii 2018:09:12:13:04:24:SJ cbx_lpm_add_sub 2018:09:12:13:04:24:SJ cbx_lpm_compare 2018:09:12:13:04:24:SJ cbx_lpm_counter 2018:09:12:13:04:24:SJ cbx_lpm_decode 2018:09:12:13:04:24:SJ cbx_mgl 2018:09:12:13:10:36:SJ cbx_nadder 2018:09:12:13:04:24:SJ cbx_nightfury 2018:09:12:13:04:24:SJ cbx_stratix 2018:09:12:13:04:24:SJ cbx_stratixii 2018:09:12:13:04:24:SJ cbx_stratixiii 2018:09:12:13:04:24:SJ cbx_stratixv 2018:09:12:13:04:24:SJ cbx_tgx 2018:09:12:13:04:24:SJ cbx_zippleback 2018:09:12:13:04:24:SJ  VERSION_END
// synthesis VERILOG_INPUT_VERSION VERILOG_2001
// altera message_off 10463



// Copyright (C) 2018  Intel Corporation. All rights reserved.
//  Your use of Intel Corporation's design tools, logic functions 
//  and other software and tools, and its AMPP partner logic 
//  functions, and any output files from any of the foregoing 
//  (including device programming or simulation files), and any 
//  associated documentation or information are expressly subject 
//  to the terms and conditions of the Intel Program License 
//  Subscription Agreement, the Intel Quartus Prime License Agreement,
//  the Intel FPGA IP License Agreement, or other applicable license
//  agreement, including, without limitation, that your use is for
//  the sole purpose of programming logic devices manufactured by
//  Intel and sold by Intel or its authorized distributors.  Please
//  refer to the applicable agreement for further details.



//synthesis_resources = cyclone10lp_oscillator 1 
//synopsys translate_off
`timescale 1 ps / 1 ps
//synopsys translate_on
module  internal_osc
	( 
	clkout,
	oscena) /* synthesis synthesis_clearbox=1 */;
	output   clkout;
	input   oscena;

	wire  wire_sd1_clkout;

	cyclone10lp_oscillator   sd1
	( 
	.clkout(wire_sd1_clkout),
	.oscena(oscena));
	assign
		clkout = wire_sd1_clkout;
endmodule //internal_osc
//VALID FILE
