camerondm9/ece4600capstone/Microcontroller/xoshiro.c

/*  Written in 2019 by David Blackman and Sebastiano Vigna (vigna@acm.org)

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
See <http://creativecommons.org/publicdomain/zero/1.0/>. */

#include "xoshiro.h"

/* This is xoshiro128++ 1.0, one of our 32-bit all-purpose, rock-solid
   generators. It has excellent speed, a state size (128 bits) that is
   large enough for mild parallelism, and it passes all tests we are aware
   of.

   For generating just single-precision (i.e., 32-bit) floating-point
   numbers, xoshiro128+ is even faster.

   The state must be seeded so that it is not everywhere zero. */


static inline uint32_t rotl(const uint32_t x, int k)
{
	return (x << k) | (x >> (32 - k));
}


uint32_t xoshiro_state[4];

uint32_t xoshiro_next(void)
{
	uint32_t* const s = xoshiro_state;

	const uint32_t result = rotl(s[0] + s[3], 7) + s[0];
	
	const uint32_t t = s[1] << 9;
	
	s[2] ^= s[0];
	s[3] ^= s[1];
	s[1] ^= s[2];
	s[0] ^= s[3];
	
	s[2] ^= t;
	
	s[3] = rotl(s[3], 11);
	
	return result;
}
