camerondm9/ece4600capstone/(commit log)

2019-10-11 Add support for making sample rate and chirp depend on center frequency, add preliminary support for determining threshold automatically, compute error between correlation result and perfect result, 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
2019-10-18 Clarify simulation parameters, add parameter for gain, add error handling, make filtering more agressive, remove parameter variations that are obviously bad
2019-11-13 Add empty KiCad project
    [Capstone.kicad_pcb, Capstone.sch]
2019-11-14 Begin adding parts to KiCad library
    FPGA partially added, still needs validation
2019-11-14 Clean up FPGA symbol and footprint
2019-11-14 Add FPGA 3D model, add temperature sensor to library
    [EQFP144-PAD.step, QFN4-PAD.step]
2019-11-14 Add accelerometer
    [LGA12.step]
2019-11-14 Add RGB LED to library
    [CLMVC-FKA.step, Capstone.kicad_pcb, Capstone.sch]
2019-11-14 Add LV switching regulator to library
    [Capstone.sch, LvPower.sch, WSON10-PAD.step]
2019-11-14 Add oscillator to library
    [ECS-5032MV.step]
2019-11-14 Add DAC and ADC to library, make footprints more consistent
    [SOT23.step, TSOT8.step]
2019-11-14 Added schematic sheets
    [Capstone.sch, Fpga.sch, HvPower.sch, LvPower.sch, Microcontroller.sch, Receive.sch, Transmit.sch]
2019-11-15 Add diode pair to library
    [Capstone.sch, Connectors.sch, Fpga.sch, HvPower.sch, LvPower.sch, MMBD7000L.step, Microcontroller.sch, Receive.sch]
2019-11-15 Add microcontroller/radio module to library
    [BMD-360.step, Microcontroller.sch]
2019-11-15 Cleanup FPGA ground pins in library, begin adding components to schematic
    [Fpga.sch, LvPower.sch, Microcontroller.sch]
2019-11-15 Add push button to library
    [Microcontroller.sch, PTS645SK43SM.step]
2019-11-15 Add linear regulator and JST-PH connector to library
    [LvPower.sch, S2B-PH-SM4-TB.step, SOT23-5.step]
2019-11-15 Added JST-PH connector to schematic
    Orientation of JST-PH connector matches Adafruit Li-ion cells
    [Connectors.sch]
2019-11-15 Switch to cheaper linear regulator (with better datasheet), finish LvPower schematic
    [LvPower.sch]
2019-11-16 Added "near radio" warning to microcontroller pins, connected more ICs to power rails, added transducer capacitive coupling
    [Connectors.sch, Fpga.sch, HvPower.sch, LvPower.sch, Microcontroller.sch, Receive.sch, Transmit.sch]
2019-11-16 Begin adding FPGA connections for JTAG
    [Connectors.sch, Fpga.sch]
2019-11-16 Add debug headers for FPGA and microcontroller
    [Connectors.sch, Fpga.sch, Microcontroller.sch]
2019-11-17 Add connections between FPGA and microcontroller
    [Fpga.sch, Microcontroller.sch]
2019-11-17 Connect LED to microcontroller, add another debugging header
    [Connectors.sch, Microcontroller.sch]
2019-11-17 Connect push buttons to microcontroller, connect I2C lines, add GPIO links between microcontroller and FPGA
    [Fpga.sch, Microcontroller.sch]
2019-11-17 Add high-voltage transmit amplifier to library
    [SOIC8-PAD.step, Transmit.sch]
2019-11-18 Fixed mistake on FPGA power supplies
    VCCD_PLL lines were connected to the wrong supply. They need to match the core voltage.
    [Fpga.sch]
2019-11-18 Add buck regulator to part library
    [WSON6-PAD.step]
2019-11-18 Switch 1.2V supply to use new buck regulator
    [LvPower.sch]
2019-11-18 Connect oscillator to power
    [Fpga.sch]
2019-11-18 Change TPS63030 to TPS63031 to reduce complexity
    Parts are the same family, same footprint, same cost, but TPS63031 is a fixed 3.3V version, so it saves us a resistor divider.
    [LvPower.sch]
2019-11-18 Add microcontroller/radio module to parts file
    This file should really be replaced with a KiCad BOM
2019-11-19 Added low-noise supply rails, changed 100nF capacitors to 0603 footprint, fixed ENS210 footprint, added decoupling capacitors to microcontroller
    [Fpga.sch, LvPower.sch, Microcontroller.sch, Receive.sch]
2019-11-26 Add 100m resistors to improve filter performance
    [LvPower.sch]
2019-11-28 Add LMR62421 regulator and inductor to library, draw schematic for 12V supply, add HV-ENABLE pin to microcontroller
    [HvPower.sch, Microcontroller.sch, NRS6045T100MMGK.step, WSON6-2x2-PAD.step, WSON6-3x3-PAD.step]
2019-12-02 Add datasheets for HV switching regulators
2019-12-02 Add datasheet for 50V regulator's MOSFET
2019-12-02 Add 50V regulator schematic, change 12V diode to be the same as 50V diode
    [HvPower.sch, SSOP8.step, UDFN6-FET-PAD.stp]
2019-12-02 Touchup footprints, add soldered jumpers to HV power supplies
    [HvPower.sch]
2019-12-02 Added soldered jumpers to LV power schematic
    [HvPower.sch, LvPower.sch]
2019-12-03 Add connectors for all power supplies
    [Connectors.sch]
2019-12-05 Add decoupling and bulk capacitance for FPGA
    [Fpga.sch, LvPower.sch]
2019-12-05 Add comparator to monitor 50V supply, add flash memory for storing FPGA config data
    [Fpga.sch, Microcontroller.sch, SOT353.step]
2019-12-08 Add transmit preamplifier to library and schematic
    [Transmit.sch]
2019-12-08 Additional note
    [Transmit.sch]
2019-12-08 Switch to diodes that will waste less transmit power, add amplifier to generate transmit midrail, add enable signal to final amplifier
    Enable signal to final amplifier is important, as it will allow us to conserve power when not transmitting. This should help keep the amplifier from overheating.
    [MMBD7000L.step, Microcontroller.sch, Receive.sch, Transmit.sch]
2019-12-09 Add decoupling for other FPGA supplies
    [Fpga.sch, LvPower.sch, Transmit.sch]
2019-12-09 Connect signals to FPGA, normalize appearance of footprints
    [Fpga.sch]
2019-12-09 Add decoupling capacitors for components without
    [Connectors.sch, HvPower.sch, LvPower.sch, Microcontroller.sch, Receive.sch, Transmit.sch]
2019-12-12 Changed transmit-enable to connect to FPGA instead of microcontroller, added 10V linear regulator
    [Fpga.sch, HvPower.sch, Microcontroller.sch, Transmit.sch]
2019-12-12 Prepare for receive opamps
    [Receive.sch]
2019-12-13 Added receive amplification circuit, added opamps for receive to library, added digital potentiometer to library, connected VGA stages to FPGA
    [Fpga.sch, Receive.sch, SSOP14.step, TDFN8.step]
2019-12-13 Bring additional signals to the connectors sheet for debug access
    [Connectors.sch, Fpga.sch, Microcontroller.sch, Receive.sch]
2019-12-13 Switch 3.3V analog circuitry to low noise supply, fix pin classifications on some parts, swap 9V connector for 10V
    [Connectors.sch, Receive.sch, Transmit.sch]
2019-12-13 Add missing footprints
    [Connectors.sch, Fpga.sch, HvPower.sch, LvPower.sch]
2019-12-13 Annotate schematic, simplify transmit circuit, shuffle receive opamp stages, reorder buttons so they match net names, reorder connectors to simplify routing, begin arranging parts on PCB
    [Capstone.kicad_pcb, Connectors.sch, Fpga.sch, HvPower.sch, LvPower.sch, Microcontroller.sch, Receive.sch, Transmit.sch]
2019-12-16 Begin layout around FPGA and microcontroller, rearrange some connections to FPGA and microcontroller, change groupings of optional debug pins
    [Capstone.kicad_pcb, Connectors.sch, Fpga.sch, Microcontroller.sch, Receive.sch, Transmit.sch]
2019-12-17 Remove unnecessary series resistors, rearrange connections on FPGA and microcontroller, rearrange debug pins, layout most of FPGA and microcontroller sections
    [Capstone.kicad_pcb, Connectors.sch, Fpga.sch, HvPower.sch, Microcontroller.sch, Receive.sch, Transmit.sch]
2019-12-17 Move footprint values to fabrication layer
2019-12-17 Add ground to EPAD connection to digital potentiometers
2019-12-17 Rearrange FPGA connections, combine VGA and ADC debug headers, layout most of VGA and ADC circuits
    [Capstone.kicad_pcb, Connectors.sch, Fpga.sch]
2019-12-17 Add additional mounting holes, optimize receive power supply connections for layout, simplify FPGA analog ground, layout 3v3 and 1v2 supplies
    [Capstone.kicad_pcb, Connectors.sch, Fpga.sch, Receive.sch, Transmit.sch]
2019-12-18 Complete preliminary layout, add U of M logo for bottom silkscreen
    Still need to run DRC and fix issues
    Still need to fix top silkscreen so references are actually readable
    Still need to fix bottom silkscreen to show group names
    [Capstone.kicad_pcb, SRU1048-151Y.stp]
2019-12-18 Fix DRC errors, fix 3D models for all important parts
    [Capstone.kicad_pcb, LQH3NP_M0.stp]
2019-12-19 Give 50V traces extra clearance, add names to bottom silkscreen
    [Capstone.kicad_pcb]
2019-12-19 Optimize routing on bottom of PCB for increased GND plane connectivity
    [Capstone.kicad_pcb]
2019-12-19 Partially fix silkscreen
    Component names are (technically) readable now. You just can't tell which is which...
    [Capstone.kicad_pcb]
2019-12-19 Create footprint for bottom silkscreen with group names and number
    Generated from an SVG file.
    Contains UofM logo/crest, group names, and group number.
2019-12-21 Connect more FPGA pins to GND, improve continuity of GND plane
    [Capstone.kicad_pcb, Fpga.sch]
2019-12-21 Add bottom logo
    [Capstone.kicad_pcb]
2019-12-21 Add project title to bottom of board
    [Capstone.kicad_pcb]
2019-12-23 Adjust receive circuit to increase stability (hopefully less likely to oscillate)
    [Capstone.kicad_pcb, Connectors.sch, Fpga.sch, Receive.sch, Transmit.sch]
2019-12-23 Move FPGA SPI-DOUT pin to make Quartus happy
    [Capstone.kicad_pcb, Connectors.sch, Fpga.sch]
2020-01-02 Add ground fill around edge of top layer
    [Capstone.kicad_pcb]
2020-01-07 Add bills of materials and merge/compare script
    [layout.csv, merged.csv, schematic.csv]
2020-01-07 Update BOMs
    [layout.csv, merged.csv, schematic.csv]
2020-01-07 Tiny fixes to the schematic
    [Capstone.kicad_pcb, Connectors.sch, Microcontroller.sch, layout.csv, merged.csv, schematic.csv]
2020-01-10 Adjust design rules slightly, reroute affected traces
    [Capstone.kicad_pcb]
2020-01-10 Fix incorrect footprint, begin organizing fabrication layer
    [Capstone.kicad_pcb, Transmit.sch]
2020-01-10 Update BOMs with fixed footprint
    [layout.csv, merged.csv, schematic.csv]
2020-01-10 Fix resistors to use resistor footprints
    [Capstone.kicad_pcb, HvPower.sch, layout.csv, merged.csv, schematic.csv]
2020-01-10 Fix incorrect footprint on power supply diodes
    [Capstone.kicad_pcb, DO-220AA.step, HvPower.sch, layout.csv, merged.csv, schematic.csv]
2020-01-10 Generate output files for manufacturing
    [Capstone-B_Cu.gbr, Capstone-B_Mask.gbr, Capstone-B_SilkS.gbr, Capstone-Edge_Cuts.gbr, Capstone-F_Cu.gbr, Capstone-F_Mask.gbr, Capstone-F_SilkS.gbr, Capstone-In1_Cu.gbr]
2020-01-16 added solidworks model
    [2 Pin Header.SLDPRT, Base.SLDPRT, Battery.SLDPRT, Button Extender.SLDPRT, Cone Mount.SLDPRT, Cone Support.SLDPRT, Cone.SLDPRT, Cover.SLDPRT]
2020-01-16 Reorganize mech CAD files
    [2 Pin Header.SLDPRT, Base.SLDPRT, Battery.SLDPRT, Button Extender.SLDPRT, Cone Mount.SLDPRT, Cone Support.SLDPRT, Cone.SLDPRT, Cover.SLDPRT]
2020-01-16 added centering features to cone supports
    [Cone Mount.SLDPRT, Cone Support.SLDPRT, Emittor Mounting.SLDPRT]
2020-01-27 Record pin-peripheral mappings
    (peripherals in rough order of importance)
2020-01-27 Add pin file for devkit
2020-01-28 Updated hole sizing and added cone drawing
    [Base.SLDPRT, Cone.SLDPRT, ConeRev0.SLDDRW, Cover.SLDPRT, Emittor Mounting.SLDPRT]
2020-01-29 Add package datasheet for another Intel FPGA
    To help locate pin 1, since the parts we received don't match the Cyclone datasheet. Having another Altera/Intel part as a reference is useful.
2020-01-29 changed the angle of the cone from 47.5 deg. to 46.5 deg. also updated the pdf drawing to rev.1
    [Cone.SLDPRT, ConeRev0.SLDDRW]
2020-01-31 changed tolerance for cone
    [Emittor Mounting.SLDPRT]
2020-01-31 more updates to CAD model
    [Cone Support.SLDPRT, Machine Screw (91772A150).SLDPRT, Machine Screw (92095A119).SLDPRT]
2020-02-04 added protective housing to the emittor
    [Base.SLDPRT, Button Extender.SLDPRT, Cone Mount 3 Wing.SLDPRT, Emittor Cover.SLDPRT, Emittor Mounting 3 Wing.SLDPRT, Emittor Mounting.SLDPRT]
2020-02-20 Configure project, convert pinout files into code, add lockless queue implementation, begin UART testing
2020-02-23 Add radio frequency table
    Copied from Bluetooth LE. No reason to reinvent the wheel...
2020-02-25 Continued work on UART comms
2020-02-26 Begin adding SPI code, add reminder to switch UART to receiving packets
2020-02-26 Figure out more of SPI code
2020-02-26 Begin work on Python side of UART
2020-03-01 Continue work towards UART comms
2020-03-02 Complete UART code from computer to board
2020-03-03 Fix bug for minimum-size packet reception
    DMA with count 0 will fail, go directly to final packet reception code
    [uart.c]
2020-03-04 Fix header search Python code
    [uart.py]
2020-03-04 Begin work on SPI transfers
2020-03-04 Write core SPI code, confirm we have to swap SPI pins back and forth
    Quartus won't allow us to use the same SPI pins for the flash memory and the FPGA on this PCB revision. It would make the code a little simpler, but we don't have time for another PCB revision.
    [CapstoneFpga.v, main.c, pins.h, spi.c, spi.h]
2020-03-06 Add test counter to FPGA
    Uses the internal oscillator so we don't need to solder the crystal onto the PCBs yet
    [CapstoneFpga.v, internal_osc.v]
2021-01-14 Move 2.7k receive resistor to the correct location
    [Capstone.kicad_pcb, Capstone.sch, Connectors.sch, Fpga.sch, HvPower.sch, LvPower.sch, Microcontroller.sch, Receive.sch]
2021-02-16 Increase robustness of UART packet code
2021-02-16 Prototype position simulation
2021-02-17 Fix bug in Python UART packet code
    [uart.py]
2024-04-24 Fix error in idle code
    [main.c, uart.c]
