camerondm9/ece4600capstone/(notices)

Notices in the files:
Microcontroller/xoshiro.c:
and related and neighboring rights to this software to the public domain
